ruledicaprio/solar-rfp-engine/rfp-hybrid-solar-td/review/ODGOVOR-RECENZENTU-2026-08-27.md

# Odgovor na komentare recenzenta — A. Čolpa, 27.08.2026

**Predmet:** komentari na `3.1 PRILOG II TD — predmjer Sjednica, Bileća` (7 komentara
u ćelijama) i na `proračuni_sjednica` (2 komentara, strana 4).
**Status:** svi komentari usvojeni i sprovedeni.
**Datum odgovora:** 14.09.2026.

Količine u odgovorima odnose se na važeći raspored temelja — **8 temeljnih traka**
(2 po nosaču). U verziji koju ste pregledali bilo ih je 6.

| # | Gdje | Komentar | Ishod |
|---|---|---|---|
| K1 | predmjer, 1.1 | tehničko rješenje uz ponudu | usvojeno |
| K2 | predmjer, 1.2 | izbaciti sile čupanja / podizanja / momente | usvojeno |
| K3 | predmjer, 1.3 | izbaciti pritisak vjetra i koeficijente; ostaviti standarde; proračun kao uslov za početak radova | usvojeno |
| K4 | predmjer, 2.1 | prekontrolisati iskop po traci | prekontrolisano |
| K5 | predmjer, 2.2 | nejasno zatrpavanje | stavka obrisana |
| K6 | predmjer, 2.2a | prekontrolisati nakon usaglašavanja 2.1 i 2.2 | prekontrolisano |
| K7 | predmjer, 2.3 | prekontrolisati količinu betona | prekontrolisano |
| P1 | proračun, B.3 | 110 kg po nosaču je premalo — brisati procjenu | usvojeno |
| P2 | proračun, B.6 | širi temelj u dnu se u stijeni teško izvodi | usvojeno |

---

## K1 — predmjer, stavka 1.1

> „U stavku 1.1 bih dodao da je ponuđač obavezan da uz ponudu dostavi tehničko rješenje
> konstrukcije za prihvat fotonaponskih panela sa obaveznim statičkim proračunom i
> specifikacijom materijala za predmetnu lokaciju."

**Sprovedeno.** Stavka 1.1 dobila je završni stav:

> „UZ PONUDU: Ponuđač je obavezan da uz ponudu dostavi tehničko rješenje konstrukcije
> za prihvat fotonaponskih panela za predmetnu lokaciju, sa obaveznim statičkim
> proračunom (Tačka 1.3) i specifikacijom materijala. Tehničko rješenje mora biti
> pregledano i odobreno prije početka izvođenja radova."

Isto je povučeno u Prilog I, Tačka 5 — dokaz br. 2 više nije samo „tehnički nacrti",
nego **tehničko rješenje konstrukcije** (nacrti + statički proračun + specifikacija
materijala), sa oznakom **PONUDA**.

## K2 — predmjer, stavka 1.2

> „Stavku 1.2 je potrebno pojednostaviti. Puno je zadano uslova koji navode na postojanje
> Glavnog projekta, kojeg nemamo. Mi tenderom tražimo izradu tehničkog rješenja, koje će
> definisati uslove ankerisanja konstrukcije. Treba izbjeći navođenje vrijednosti sila
> čupanja i podizanja, te momenata prevrtanja. […] ponuđači će nuditi različite koncepte
> konstrukcije […] iskazane vrijednosti sila i momenata prevrtanja […] uopšte ne moraju
> biti takve."

**Sprovedeno.** Iz stavke 1.2 uklonjene su sve tri zadane vrijednosti:
karakteristična sila čupanja **≥30 kN po ankeru**, projektna sila podizanja
**≥13,3 kN po nosaču** i sila po traci **≥16,1 kN**. Stav sada glasi:

> „nosivost i dubina ugradnje: prema ETA za konkretnu podlogu i prema statičkom
> proračunu iz Tačke 1.3; projektne sile ankerisanja proizlaze iz koncepta konstrukcije
> koji Ponuđač nudi i iskazuju se u tehničkom rješenju"

Isti zahvat je napravljen u **Prilogu I, Tačka 3.4 (Sidrenje)**, da specifikacija i
predmjer ne govore različito.

Zadržano je ispitivanje čupanjem na ≥10 % ugrađenih ankera do 1,5 × projektne sile —
ono se veže na silu iz ponuđačevog proračuna, ne na zadanu vrijednost.

## K3 — predmjer, stavka 1.3

> „Predlažem da se izbace vrijednosti pritiska vjetra i koeficijenata sigurnosti date
> stavkom 1.3. Ostaviti i naglasiti standarde na osnovu kojih će se raditi statički
> proračun nosive konstrukcije. Napomenu preformulisati na slijedeći način: Statički
> proračun se dostavlja u sklopu tehničkog rješenja i uslov je za počinjanje radova.
> (Statički proračun ne može biti uslov za primopredaju. Prije početka izvođenja radova
> tehničko rješenje mora biti pregledano i odobreno.)"

**Sprovedeno.** Iz stavke 1.3 izbačeni su `qp ≥ 1,20 kN/m² pri nagibu 45°` i
`γQ,dst = 1,5 / γG,stb = 0,9`. Ostali su samo standardi, uz **dopunu BAS EN 1993-1-1**
(dimenzionisanje čelične konstrukcije), koji je do sada nedostajao — bili su navedeni
samo standardi dejstava:

- BAS EN 1991-1-4 (vjetar, sa BiH nacionalnim aneksom, uključujući faktor orografije)
- BAS EN 1991-1-3 (snijeg) i radijalni led 20 mm gustine 300 kg/m³
- BAS EN 1990 (podizanje i prevrtanje)
- BAS EN 1993-1-1 (čelična konstrukcija), izvedba prema BAS EN 1090-2
- geotehnički uslovi lokacije i dubina smrzavanja

Napomena je preuzeta **doslovno po Vašem prijedlogu**. U Prilogu I, Tačka 5, uvedena je
nova oznaka **POČETAK RADOVA** i dokaz br. 1 (statički proračun) prebačen je sa
`REALIZACIJA` na `POČETAK RADOVA`.

**Jedna napomena za Vašu provjeru.** `qp ≥ 1,20 kN/m²` i `cf ≥ 1,5` zadržani su u
**Prilogu I, Tačka 3.2**, ali ne kao zahtjev prema konstrukciji, nego kao **podatak
lokaliteta** — preuzeti su iz ovjerene projektne dokumentacije lokacije i ne zavise od
koncepta koji ponuđač nudi. To je ujedno i razlog zbog kojeg se kataloški nosač ne može
prihvatiti (deklarisan na 0,52–0,87 kN/m²). Sile izvedene iz njih (podizanje,
horizontalna sila, moment prevrtanja, spreg po traci) sada su u 3.2 **izričito označene
kao orijentacione**, uz rečenicu „Projektne sile po nosaču se ne zadaju." Ako i te
orijentacione vrijednosti treba ukloniti, javite — brišu se u jednom potezu.

## K4 — predmjer, stavka 2.1 (iskop)

> „Prekontrolisati količinu iskopa po jednoj temeljnoj traci"

**Prekontrolisano, količina se ne mijenja: 9,88 m³.** Rov je sada jednoznačno opisan u
samoj stavci — širina **500 mm**, dubina **950 mm** (900 mm trake + 50 mm podložnog
betona), dužina **2600 mm**:

```
0,500 × 0,950 × 2,600 = 1,235 m³ po traci
1,235 × 8 traka       = 9,88 m³
```

Rov se siječe jednom širinom po cijeloj dubini (vidi P2), pa je osnovica rova jednaka
širini trake.

## K5 — predmjer, stavka 2.2 (zatrpavanje)

> „Nije jasno o kakvom se zatrpavanju radi, ako je količina betona približno ili skoro
> identična iskopu. Prekontrolisati stavku."

**Stavka je obrisana.** Nakon što je presjek trake postao jedinstven (P2), rov je
ispunjen u cijelosti i zatrpavanja nema:

```
beton            1,170 m³
podložni beton   0,065 m³
                 ───────
ukupno           1,235 m³  =  zapremina rova iz K4
```

Sekcija 2 je zbog toga prenumerisana **2.1 … 2.6**; jedina unakrsna referenca u
predmjeru (stavka 1.2 → „Tačka 2.3") povučena je na **Tačku 2.4**.

## K6 — predmjer, stavka 2.2a (odvoz)

> „Prekontrolisati stavku nakon usaglašavanja stavki 2.1 i 2.2"

**Prekontrolisano: 8,94 → 9,88 m³** (nova oznaka stavke: **2.2**). Pošto zatrpavanja
nema, odvozi se **sav** iskopani materijal, pa je količina jednaka iskopu iz K4.

## K7 — predmjer, stavka 2.3 (beton)

> „Prekontrolisati količinu betona. Po nacrtu datom kroz TD, količina betona je puno
> veća."

**Prekontrolisano — bili ste u pravu.** Predmjer koji ste pregledali nosio je
0,41 m³ po traci (2,44 m³ ukupno), dok je na crtežu traka puna dubine. Količina je
usaglašena sa crtežom i sada iznosi **9,36 m³** (nova oznaka stavke: **2.4**):

```
0,500 × 0,900 × 2,600 = 1,170 m³ po traci
1,170 × 8 traka       = 9,36 m³
```

Stavka sada nosi i samu izvedbu količine, pa se provjera može ponoviti iz teksta. Uz
istu izmjenu, količina obrade vidljivih površina (sada stavka **2.5**) povučena je sa
zatečenih 12 m² na izvedenih **10,4 m²** (0,50 × 2,60 × 8).

## P1 — proračun, strana 4, tačka B.3 (masa nosača)

> „110 kg po jednom nosaču je jako malo. Predlažem brisanje procjenjene količine.
> Ostaviti samo potvrđuje izvođač proračunom."

**Sprovedeno.** Brojka je obrisana iz svih tabela. U dokazu na podizanje **vlastita
težina konstrukcije se sada zanemaruje**: ona je povoljno dejstvo, pa je njeno
izostavljanje na strani sigurnosti, a stvarna masa dokaz može samo poboljšati. U
stabilizujućem dejstvu `G` ostaju samo moduli.

Posljedica je jedna izmijenjena vrijednost:

| | ranije | sada |
|---|---|---|
| `G` (stabilizujuće) | 1,9 kN (moduli + procijenjeni ram) | **0,94 kN** (samo moduli) |
| **ULS uzgon po nosaču** | 13,3 kN | **14,1 kN** |

Moment prevrtanja (25,7 kNm), spreg po traci (16,1 kN) i potrebna zapremina trake
(0,74 m³) ne zavise od mase rama i nepromijenjeni su.

## P2 — proračun, strana 4, tačka B.6 (dimenzija trake)

> „U stijeni je širi temelj u dnu jako teško izvesti. Predlažem da se dimenzija dole
> izbaci."

**Sprovedeno.** Traka je sada **jedinstvenog presjeka po cijeloj dubini**, bez
proširenja u dnu — rov se u stijeni siječe jednom širinom, a potkopavanje se ne traži.

Od dvije zatečene kote (400 gore / 500 dolje) usvojena je **veća, 500 mm**, iz dva
razloga: rov se ionako siječe na 500 mm pa se količina iskopa ne mijenja, a ankerima
ostaje 250 mm ivične udaljenosti umjesto 200 mm. Dokaz na podizanje se pritom
popravlja:

```
vlastita težina trake   1,170 × 24        =  28,1 kN
faktorisano             0,9 × 28,1        =  25,3 kN   ≥ 16,1 kN (spreg po traci)
```

**Ako ipak preferirate 400 mm** — tj. doslovno zadržavanje gornje kote — količine
slijede bez daljeg preračunavanja, a dokaz na podizanje i dalje prolazi:

| | 500 mm (usvojeno) | 400 mm (varijanta) |
|---|---|---|
| Beton po traci | 1,170 m³ | 0,936 m³ |
| Beton ukupno (8 traka) | 9,36 m³ | 7,49 m³ |
| Iskop ukupno | 9,88 m³ | 7,90 m³ |
| Odvoz ukupno | 9,88 m³ | 7,90 m³ |
| Obrada gornjih površina | 10,4 m² | 8,3 m² |
| Faktorisana težina trake | 25,3 kN | 20,2 kN |
| Prema spregu 16,1 kN | 1,57 × | 1,26 × |

Recite koju varijantu zadržavamo; u predmjer ide u jednom potezu.

---

## Gdje se izmjene vide

| Dokument | Šta je izmijenjeno |
|---|---|
| `PRILOG II — LOT 1` (obje lokacije) | stavke 1.1, 1.2, 1.3; sekcija 2 prenumerisana 2.1–2.6, obrisano zatrpavanje, količine 2.2/2.4/2.5 |
| `PRILOG I`, Tačka 3.2 | qp i cf kao podatak lokaliteta; izvedene sile označene kao orijentacione |
| `PRILOG I`, Tačka 3.4 | uklonjene zadane sile ankerisanja |
| `PRILOG I`, Tačka 3.5 | traka 500 × 2600 mm jedinstvene širine, 1,170 / 9,36 m³ |
| `PRILOG I`, Tačka 5 | nova oznaka POČETAK RADOVA; dokazi 1 i 2 |
| `proračuni`, B.3 / B.5 / B.6 | masa rama obrisana, uzgon 14,1 kN, traka jedinstvenog presjeka, izvedene količine |
| crteži `S-02`, `H-02`, `H-03` | kota trake ispisana kao jedna širina (500 × 2600 mm) |
