ruledicaprio/solar-rfp-engine/bht-sjednica-final-review/review/pvsim/fig/f5_gubici_t45.png

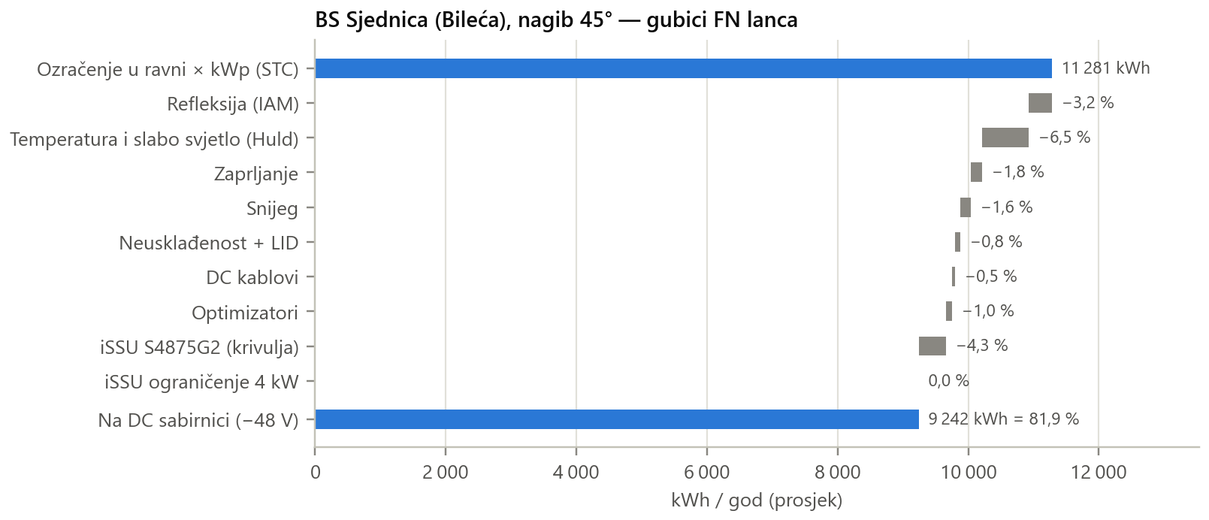
bht-sjednica-final-review/review/pvsim/fig/f5_gubici_t45.png
