ruledicaprio/solar-rfp-engine/hamzici-hybrid-solar/review/pvsim/fig/f5_gubici_t45.png

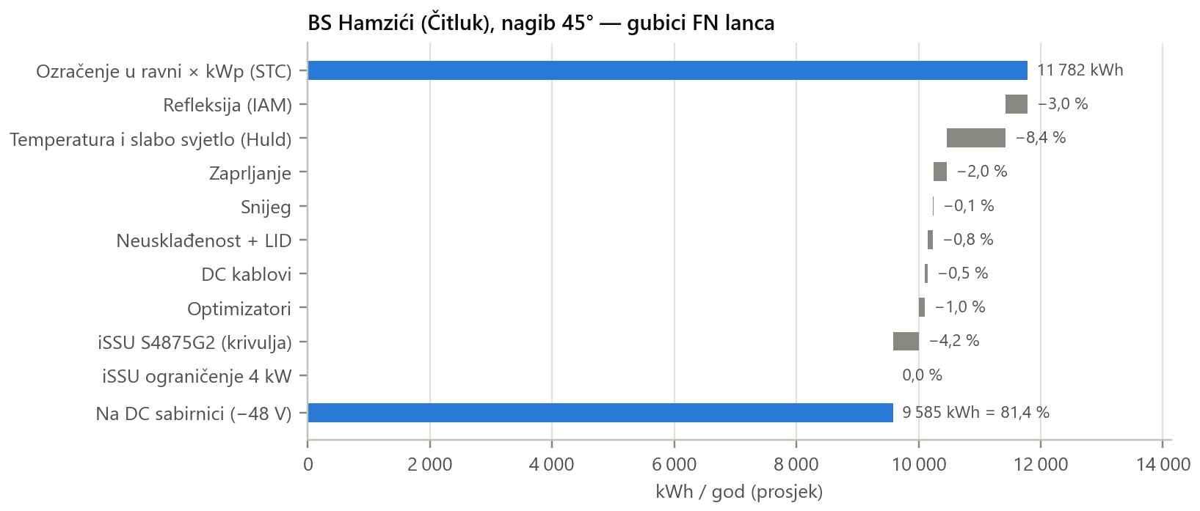
hamzici-hybrid-solar/review/pvsim/fig/f5_gubici_t45.png
