ruledicaprio/solar-rfp-engine/hamzici-hybrid-solar/review/pvsim/fig/f6_nagibi.png

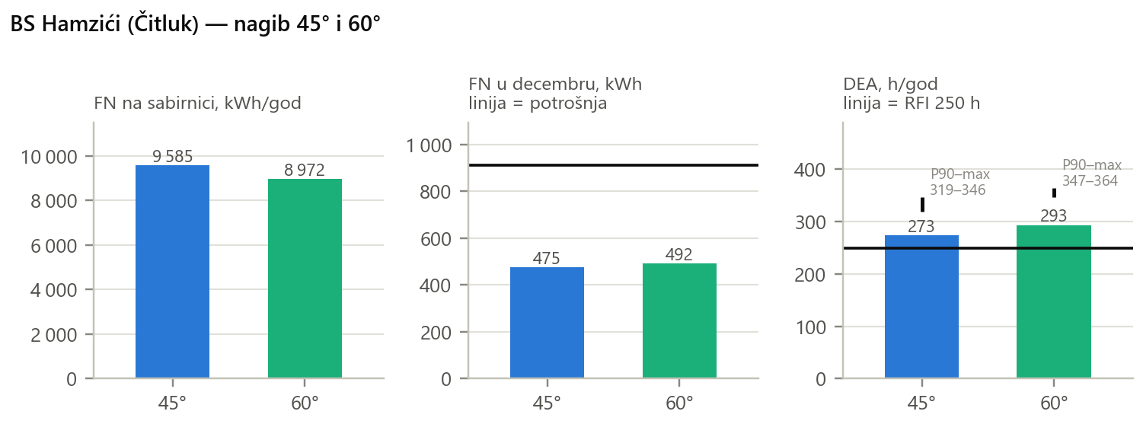
hamzici-hybrid-solar/review/pvsim/fig/f6_nagibi.png
