ruledicaprio/solar-rfp-engine/bht-sjednica-final-review/TD-OUTPUT/grafika/S-03.dxf

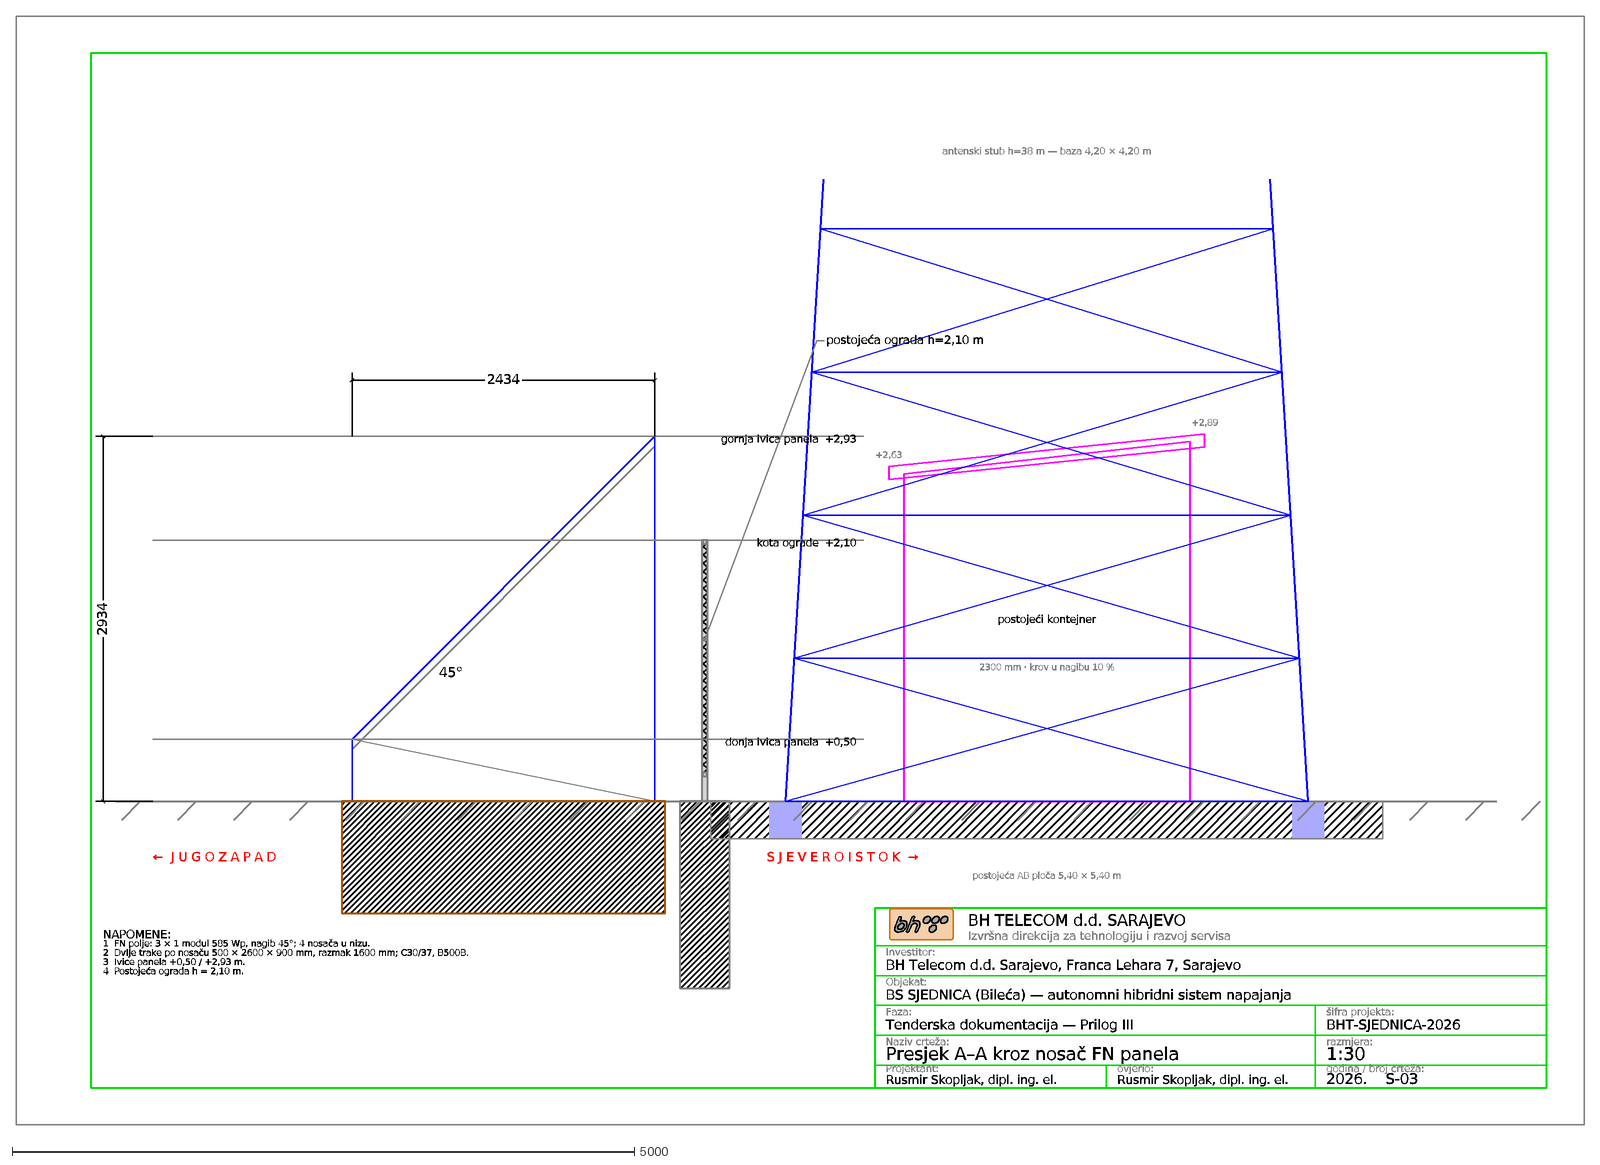
[picture p16: CAD file, 2026-10-05]
bht-sjednica-final-review/TD-OUTPUT/grafika/S-03.dxf
BH TELECOM d.d. SARAJEVO
Izvršna direkcija za tehnologiju i razvoj servisa
Investitor:
BH Telecom d.d. Sarajevo, Franca Lehara 7, Sarajevo
Objekat:
BS SJEDNICA (Bileća) — autonomni hibridni sistem napajanja
Faza:
Tenderska dokumentacija — Prilog III
šifra projekta:
BHT-SJEDNICA-2026
Naziv crteža:
Presjek A–A kroz nosač FN panela
razmjera:
1:30
Projektant:
Rusmir Skopljak, dipl. ing. el.
ovjerio:
godina / broj crteža:
2026. S-03
postojeći kontejner
2300 mm · krov u nagibu 10 %
+2,63
+2,89
postojeća AB ploča 5,40 × 5,40 m
antenski stub h=38 m — baza 4,20 × 4,20 m
donja ivica panela +0,50
kota ograde +2,10
gornja ivica panela +2,93
2434
2934
45°
S J E V E R O I S T O K →
← J U G O Z A P A D
postojeća ograda h=2,10 m
NAPOMENE:
1 FN polje: 3 × 1 modul 585 Wp, nagib 45°; 4 nosača u nizu.
2 Dvije trake po nosaču 500 × 2600 × 900 mm, razmak 1600 mm; C30/37, B500B.
3 Ivice panela +0,50 / +2,93 m.
4 Postojeća ograda h = 2,10 m.
