ruledicaprio/solar-rfp-engine/hamzici-hybrid-solar/TD-OUTPUT/grafika/H-06.dxf

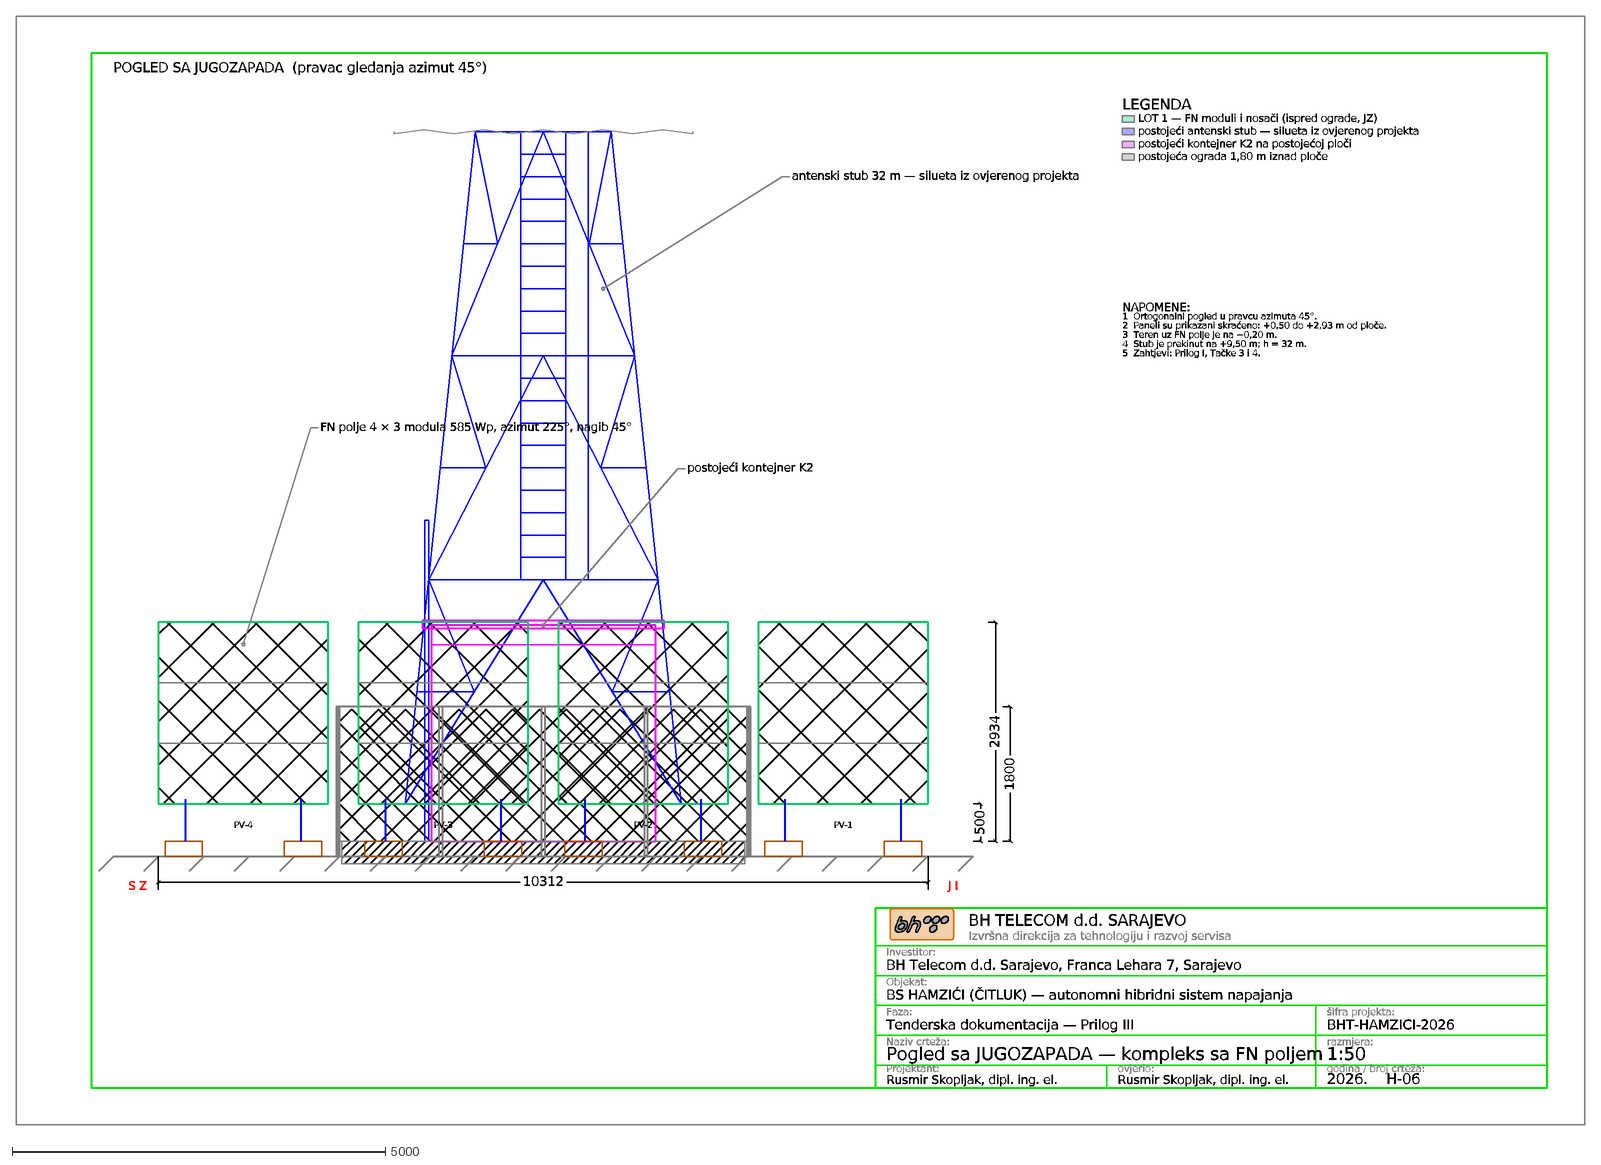
[picture p17: CAD file, 2026-10-05]
hamzici-hybrid-solar/TD-OUTPUT/grafika/H-06.dxf
BH TELECOM d.d. SARAJEVO
Izvršna direkcija za tehnologiju i razvoj servisa
Investitor:
BH Telecom d.d. Sarajevo, Franca Lehara 7, Sarajevo
Objekat:
BS HAMZIĆI (ČITLUK) — autonomni hibridni sistem napajanja
Faza:
Tenderska dokumentacija — Prilog III
šifra projekta:
BHT-HAMZICI-2026
Naziv crteža:
Pogled sa JUGOZAPADA — kompleks sa FN poljem
razmjera:
1:50
Projektant:
Rusmir Skopljak, dipl. ing. el.
ovjerio:
godina / broj crteža:
2026. H-06
PV-1
PV-2
PV-3
PV-4
10312
500
2934
1800
S Z
J I
POGLED SA JUGOZAPADA (pravac gledanja azimut 45°)
postojeći kontejner K2
antenski stub 32 m — silueta iz ovjerenog projekta
FN polje 4 × 3 modula 585 Wp, azimut 225°, nagib 45°
LEGENDA
LOT 1 — FN moduli i nosači (ispred ograde, JZ)
postojeći antenski stub — silueta iz ovjerenog projekta
postojeći kontejner K2 na postojećoj ploči
postojeća ograda 1,80 m iznad ploče
NAPOMENE:
1 Ortogonalni pogled u pravcu azimuta 45°.
2 Paneli su prikazani skraćeno: +0,50 do +2,93 m od ploče.
3 Teren uz FN polje je na −0,20 m.
4 Stub je prekinut na +9,50 m; h = 32 m.
5 Zahtjevi: Prilog I, Tačke 3 i 4.
