ruledicaprio/solar-rfp-engine/rfp-hybrid-solar-td/TD-OUTPUT/grafika/hamzici/H-02.dxf

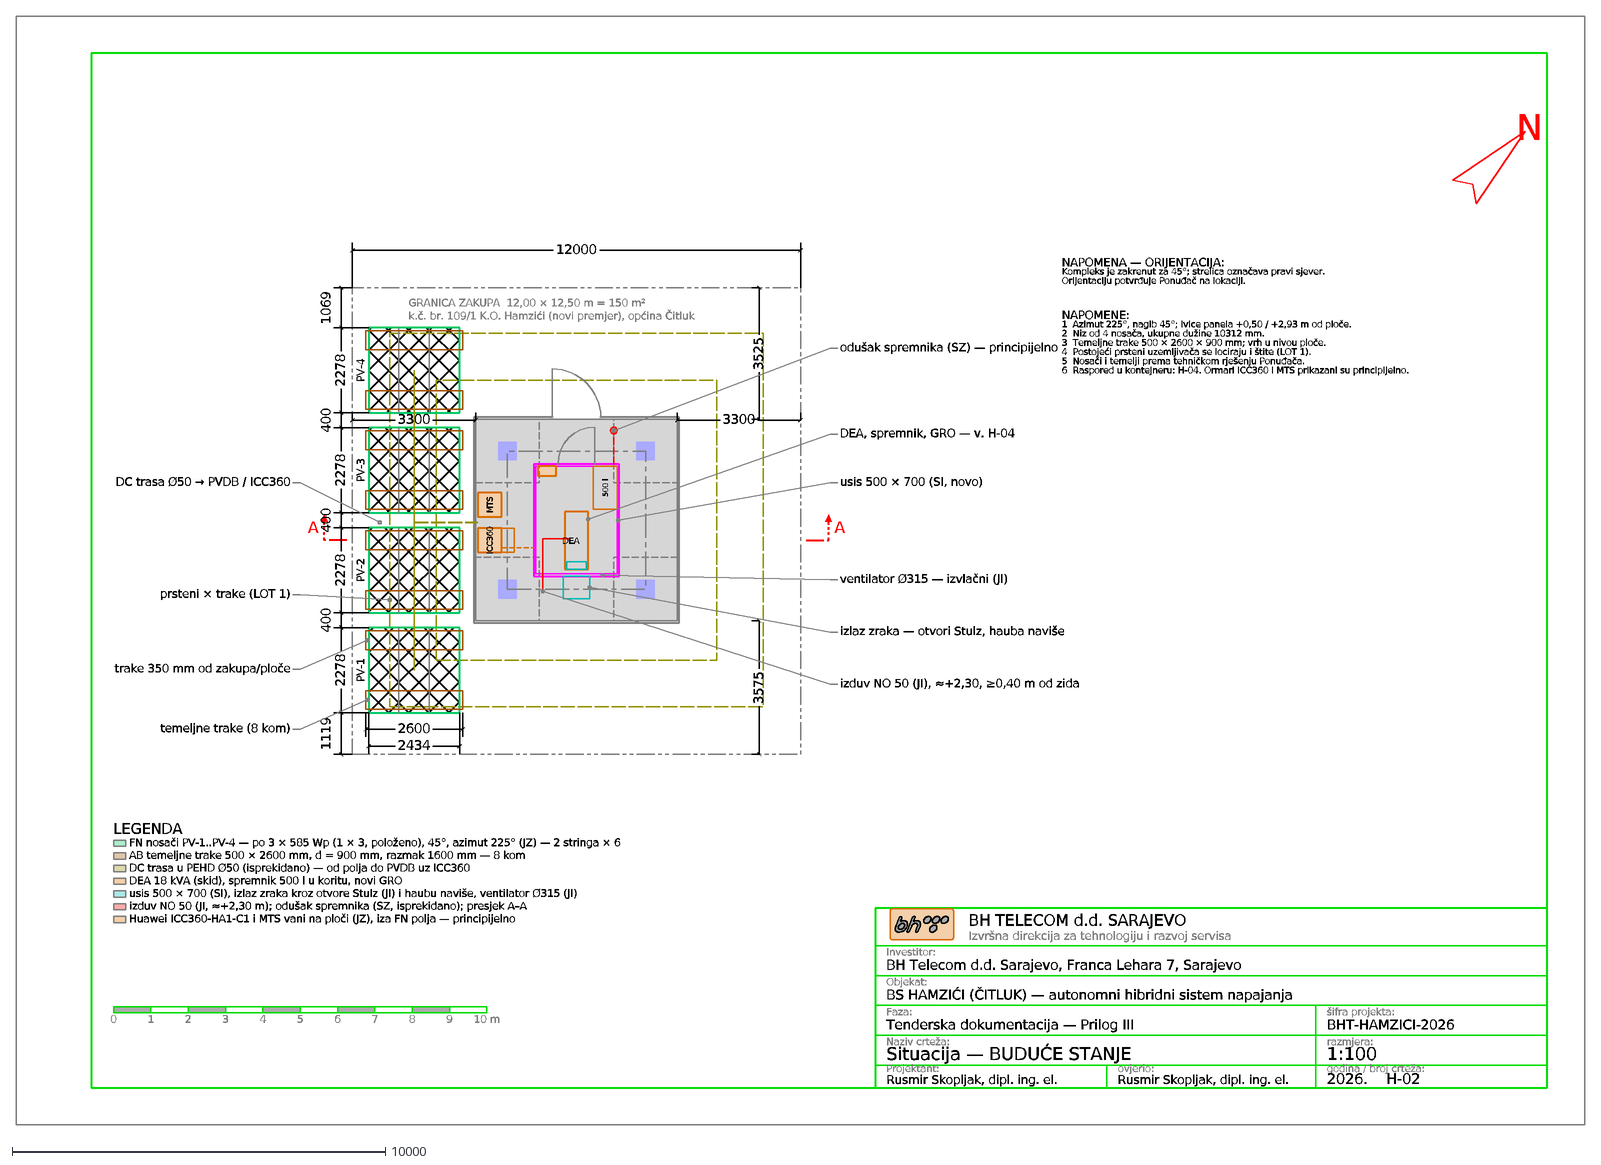
[picture p18: CAD file, 2026-10-05]
rfp-hybrid-solar-td/TD-OUTPUT/grafika/hamzici/H-02.dxf
BH TELECOM d.d. SARAJEVO
Izvršna direkcija za tehnologiju i razvoj servisa
Investitor:
BH Telecom d.d. Sarajevo, Franca Lehara 7, Sarajevo
Objekat:
BS HAMZIĆI (ČITLUK) — autonomni hibridni sistem napajanja
Faza:
Tenderska dokumentacija — Prilog III
šifra projekta:
BHT-HAMZICI-2026
Naziv crteža:
Situacija — BUDUĆE STANJE
razmjera:
1:100
Projektant:
Rusmir Skopljak, dipl. ing. el.
ovjerio:
godina / broj crteža:
2026. H-02
GRANICA ZAKUPA 12,00 × 12,50 m = 150 m²
k.č. br. 109/1 K.O. Hamzići (novi premjer), općina Čitluk
DEA
500 l
12000
3525
3575
3300
PV-1
PV-2
PV-3
PV-4
A
ICC360
MTS
1119
2278
400
1069
2600
2434
temeljne trake (8 kom)
trake 350 mm od zakupa/ploče
prsteni × trake (LOT 1)
DC trasa Ø50 → PVDB / ICC360
odušak spremnika (SZ) — principijelno
DEA, spremnik, GRO — v. H-04
usis 500 × 700 (SI, novo)
ventilator Ø315 — izvlačni (JI)
izlaz zraka — otvori Stulz, hauba naviše
izduv NO 50 (JI), ≈+2,30, ≥0,40 m od zida
N
0
1
2
3
4
5
6
7
8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
