ruledicaprio/solar-rfp-engine/bht-sjednica-final-review/TD-OUTPUT/grafika/M-01.dxf

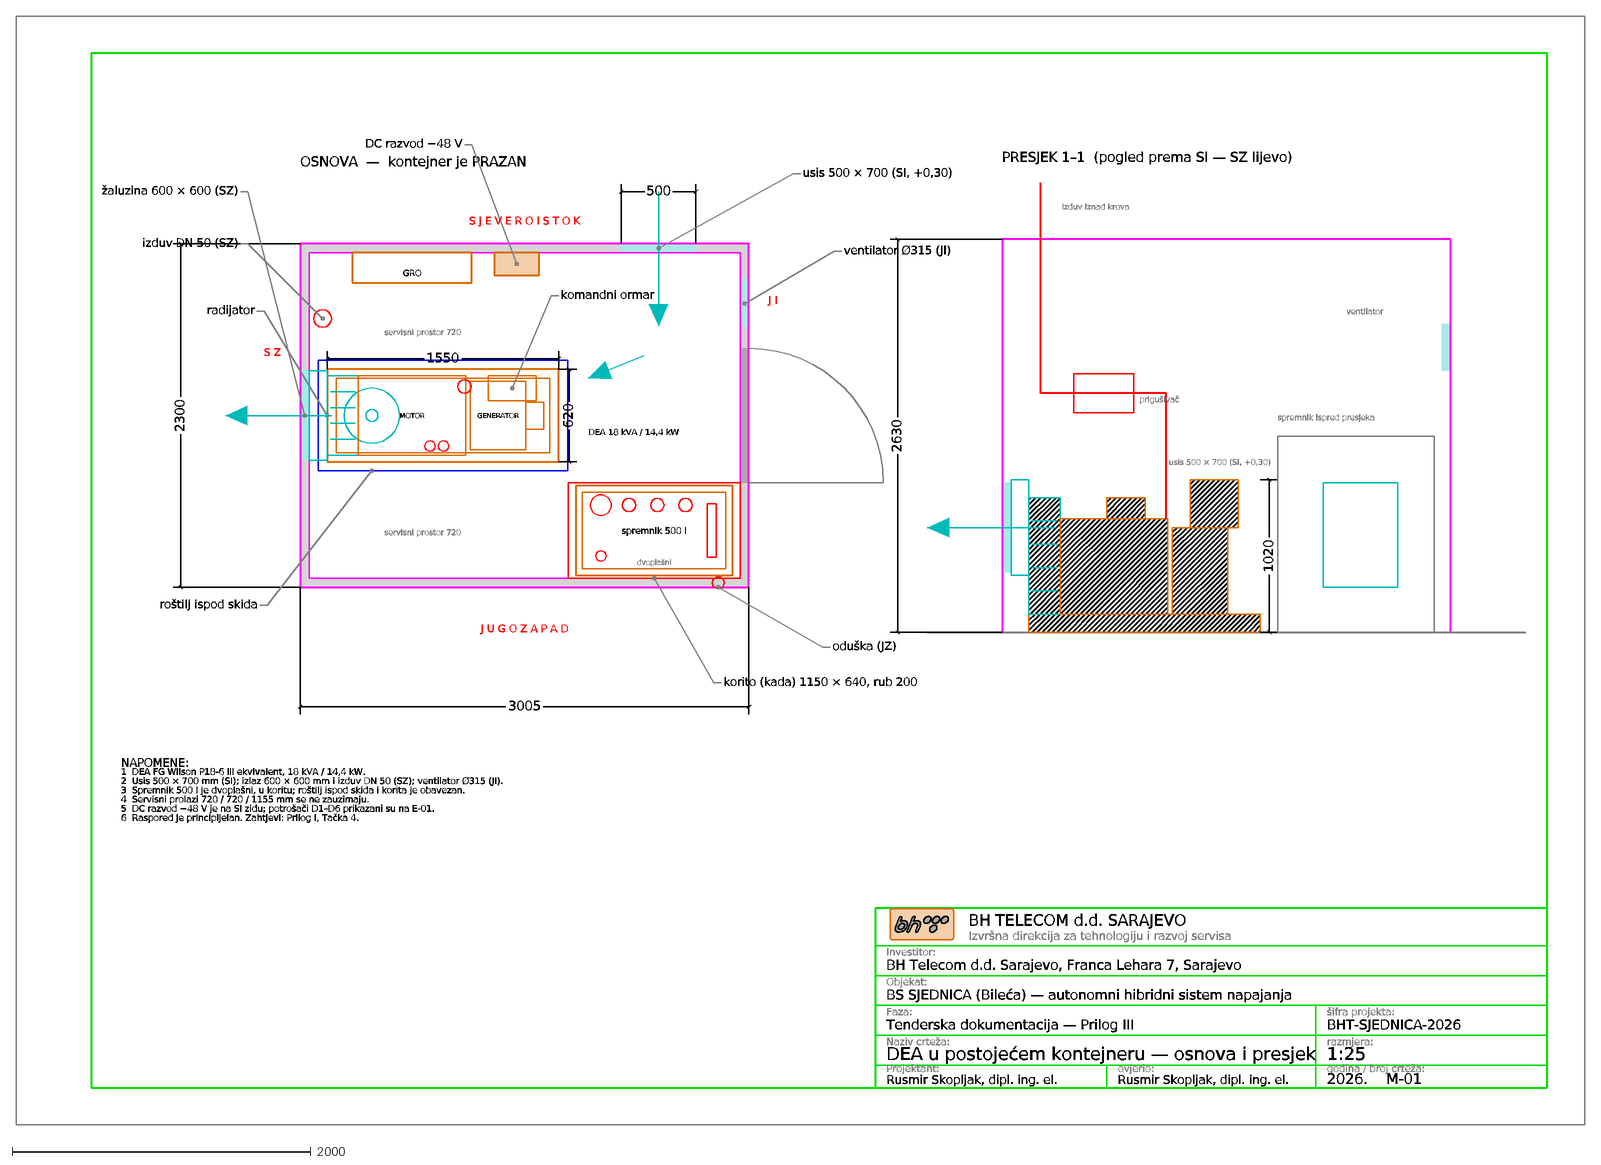
[picture p19: CAD file, 2026-10-05]
bht-sjednica-final-review/TD-OUTPUT/grafika/M-01.dxf
BH TELECOM d.d. SARAJEVO
Izvršna direkcija za tehnologiju i razvoj servisa
Investitor:
BH Telecom d.d. Sarajevo, Franca Lehara 7, Sarajevo
Objekat:
BS SJEDNICA (Bileća) — autonomni hibridni sistem napajanja
Faza:
Tenderska dokumentacija — Prilog III
šifra projekta:
BHT-SJEDNICA-2026
Naziv crteža:
DEA u postojećem kontejneru — osnova i presjek
razmjera:
1:25
Projektant:
Rusmir Skopljak, dipl. ing. el.
ovjerio:
godina / broj crteža:
2026. M-01
OSNOVA — kontejner je PRAZAN
MOTOR
GENERATOR
1550
620
radijator
komandni ormar
DEA 18 kVA / 14,4 kW
GRO
DC razvod −48 V
spremnik 500 l
dvoplašni
servisni prostor 720
3005
2300
500
usis 500 × 700 (SI, +0,30)
žaluzina 600 × 600 (SZ)
izduv DN 50 (SZ)
korito (kada) 1150 × 640, rub 200
oduška (JZ)
ventilator Ø315 (JI)
roštilj ispod skida
S J E V E R O I S T O K
J U G O Z A P A D
S Z
J I
PRESJEK 1–1 (pogled prema SI — SZ lijevo)
1020
prigušivač
izduv iznad krova
spremnik ispred presjeka
ventilator
2630
NAPOMENE:
1 DEA FG Wilson P18-6 ili ekvivalent, 18 kVA / 14,4 kW.
2 Usis 500 × 700 mm (SI); izlaz 600 × 600 mm i izduv DN 50 (SZ); ventilator Ø315 (JI).
3 Spremnik 500 l je dvoplašni, u koritu; roštilj ispod skida i korita je obavezan.
4 Servisni prolazi 720 / 720 / 1155 mm se ne zauzimaju.
5 DC razvod −48 V je na SI zidu; potrošači D1–D6 prikazani su na E-01.
6 Raspored je principijelan. Zahtjevi: Prilog I, Tačka 4.
