ruledicaprio/solar-rfp-engine/hamzici-hybrid-solar/TD-OUTPUT/grafika/H-03.dxf

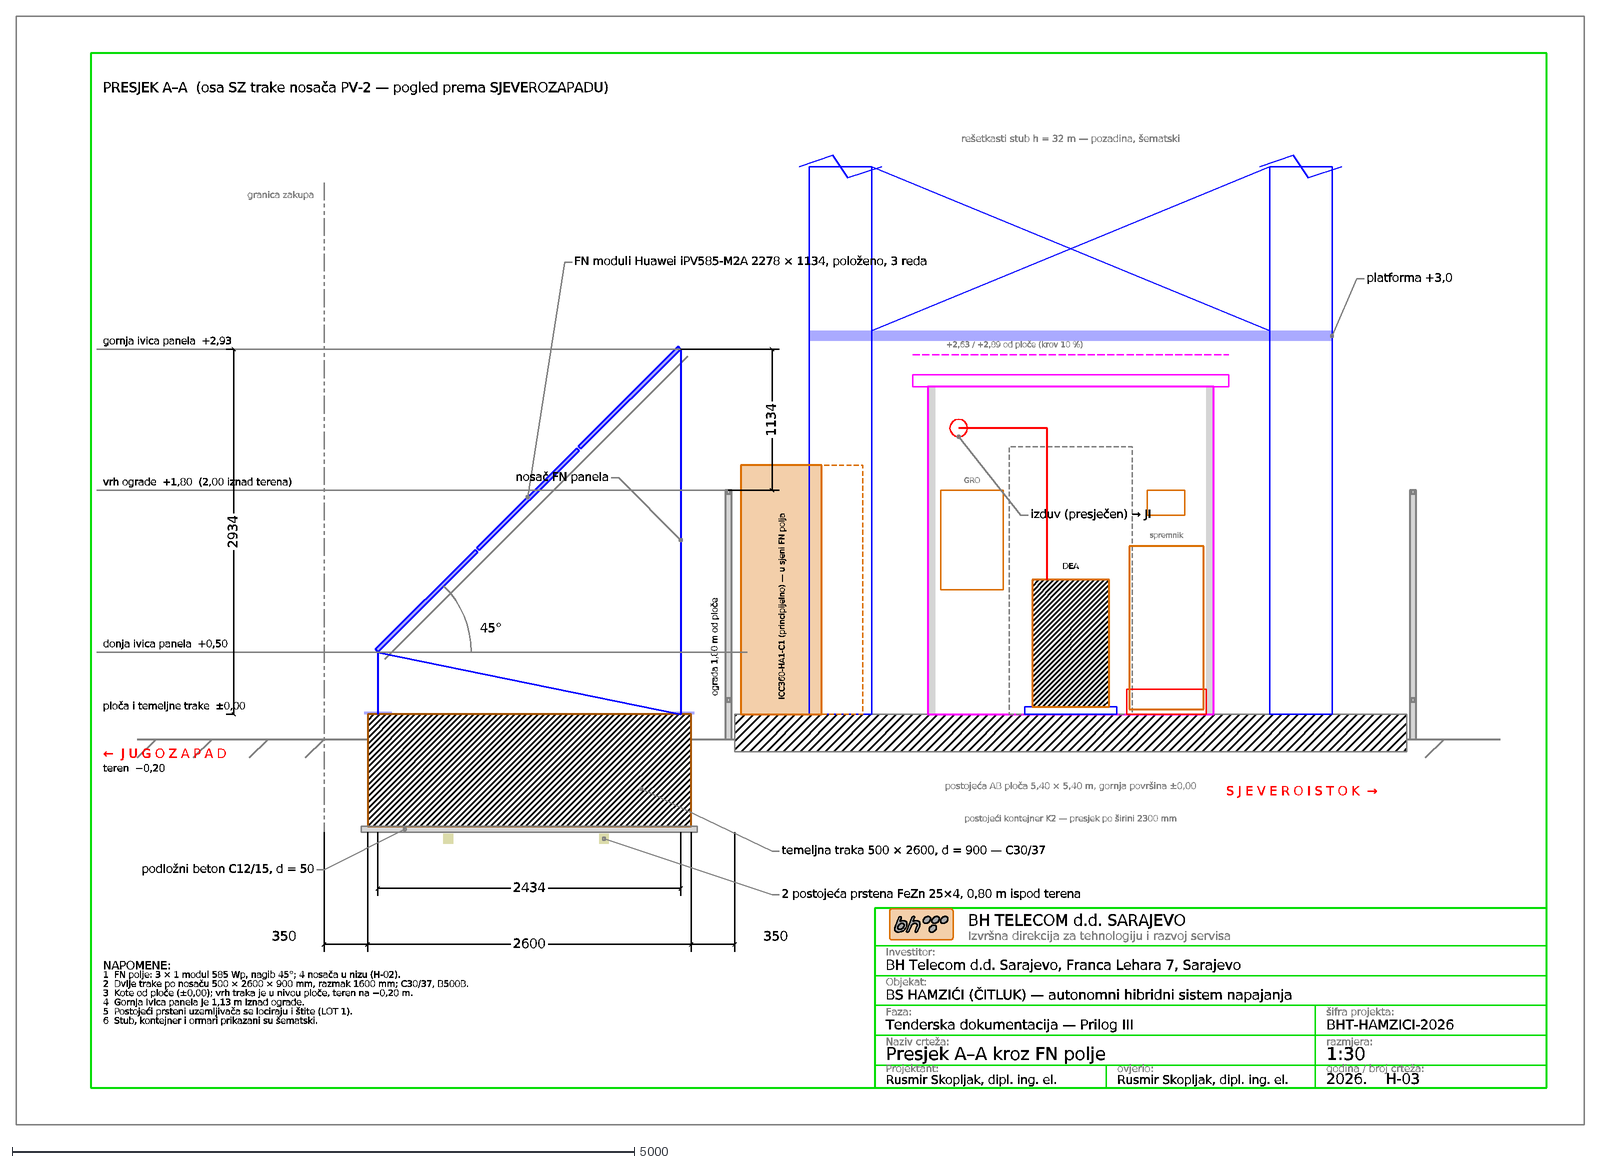
[picture p20: CAD file, 2026-10-05]
hamzici-hybrid-solar/TD-OUTPUT/grafika/H-03.dxf
BH TELECOM d.d. SARAJEVO
Izvršna direkcija za tehnologiju i razvoj servisa
Investitor:
BH Telecom d.d. Sarajevo, Franca Lehara 7, Sarajevo
Objekat:
BS HAMZIĆI (ČITLUK) — autonomni hibridni sistem napajanja
Faza:
Tenderska dokumentacija — Prilog III
šifra projekta:
BHT-HAMZICI-2026
Naziv crteža:
Presjek A–A kroz FN polje
razmjera:
1:30
Projektant:
Rusmir Skopljak, dipl. ing. el.
ovjerio:
godina / broj crteža:
2026. H-03
granica zakupa
45°
ograda 1,80 m od ploče
postojeća AB ploča 5,40 × 5,40 m, gornja površina ±0,00
rešetkasti stub h = 32 m — pozadina, šematski
platforma +3,0
ICC360-HA1-C1 (principijelno) — u sjeni FN polja
+2,63 / +2,89 od ploče (krov 10 %)
GRO
spremnik
DEA
postojeći kontejner K2 — presjek po širini 2300 mm
donja ivica panela +0,50
vrh ograde +1,80 (2,00 iznad terena)
gornja ivica panela +2,93
ploča i temeljne trake ±0,00
teren −0,20
2934
1134
2434
350
2600
FN moduli Huawei iPV585-M2A 2278 × 1134, položeno, 3 reda
nosač FN panela
temeljna traka 500 × 2600, d = 900 — C30/37
2 postojeća prstena FeZn 25×4, 0,80 m ispod terena
podložni beton C12/15, d = 50
izduv (presječen) → JI
PRESJEK A–A (osa SZ trake nosača PV-2 — pogled prema SJEVEROZAPADU)
← J U G O Z A P A D
S J E V E R O I S T O K →
NAPOMENE:
1 FN polje: 3 × 1 modul 585 Wp, nagib 45°; 4 nosača u nizu (H-02).
2 Dvije trake po nosaču 500 × 2600 × 900 mm, razmak 1600 mm; C30/37, B500B.
3 Kote od ploče (±0,00); vrh traka je u nivou ploče, teren na −0,20 m.
4 Gornja ivica panela je 1,13 m iznad ograde.
5 Postojeći prsteni uzemljivača se lociraju i štite (LOT 1).
6 Stub, kontejner i ormari prikazani su šematski.
