ruledicaprio/solar-rfp-engine/bht-sjednica-final-review/TD-OUTPUT/grafika/S-04.dxf

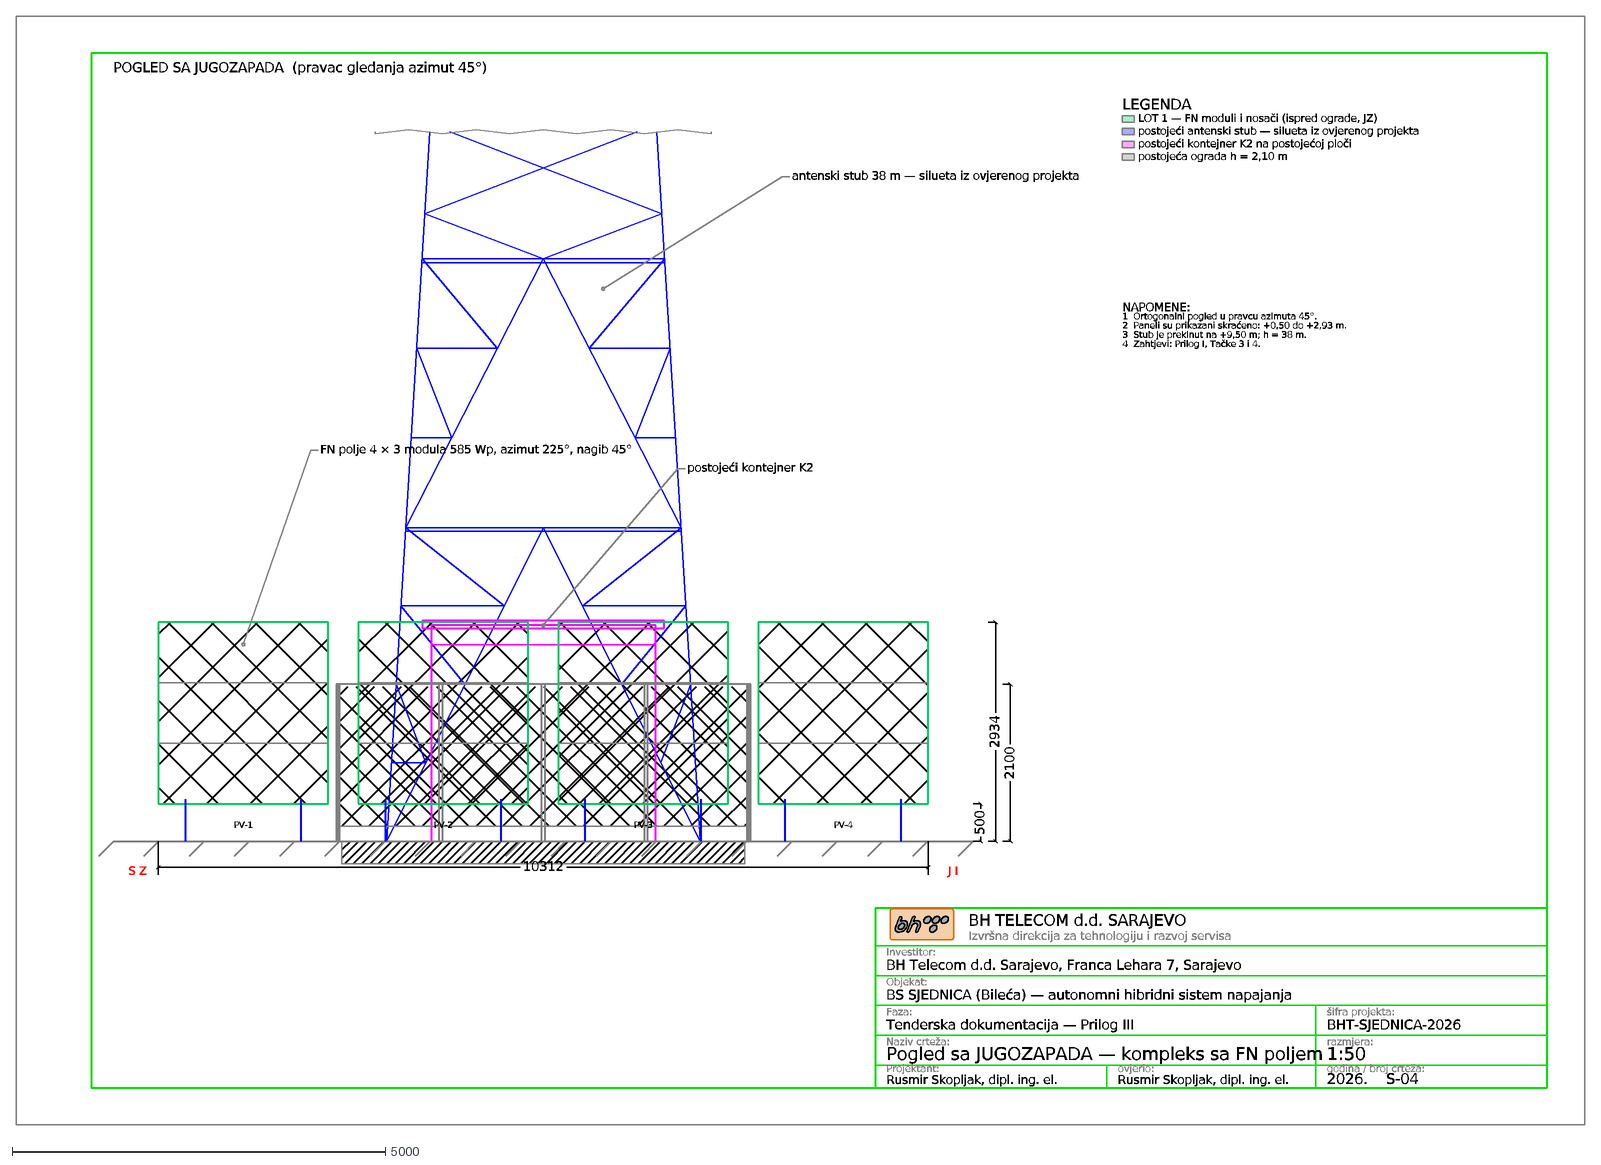
[picture p21: CAD file, 2026-10-05]
bht-sjednica-final-review/TD-OUTPUT/grafika/S-04.dxf
BH TELECOM d.d. SARAJEVO
Izvršna direkcija za tehnologiju i razvoj servisa
Investitor:
BH Telecom d.d. Sarajevo, Franca Lehara 7, Sarajevo
Objekat:
BS SJEDNICA (Bileća) — autonomni hibridni sistem napajanja
Faza:
Tenderska dokumentacija — Prilog III
šifra projekta:
BHT-SJEDNICA-2026
Naziv crteža:
Pogled sa JUGOZAPADA — kompleks sa FN poljem
razmjera:
1:50
Projektant:
Rusmir Skopljak, dipl. ing. el.
ovjerio:
godina / broj crteža:
2026. S-04
PV-1
PV-2
PV-3
PV-4
10312
500
2934
2100
S Z
J I
POGLED SA JUGOZAPADA (pravac gledanja azimut 45°)
postojeći kontejner K2
antenski stub 38 m — silueta iz ovjerenog projekta
FN polje 4 × 3 modula 585 Wp, azimut 225°, nagib 45°
LEGENDA
LOT 1 — FN moduli i nosači (ispred ograde, JZ)
postojeći antenski stub — silueta iz ovjerenog projekta
postojeći kontejner K2 na postojećoj ploči
postojeća ograda h = 2,10 m
NAPOMENE:
1 Ortogonalni pogled u pravcu azimuta 45°.
2 Paneli su prikazani skraćeno: +0,50 do +2,93 m.
3 Stub je prekinut na +9,50 m; h = 38 m.
4 Zahtjevi: Prilog I, Tačke 3 i 4.
