ruledicaprio/solar-rfp-engine/bht-sjednica-final-review/TD-OUTPUT/grafika/S-02.dxf

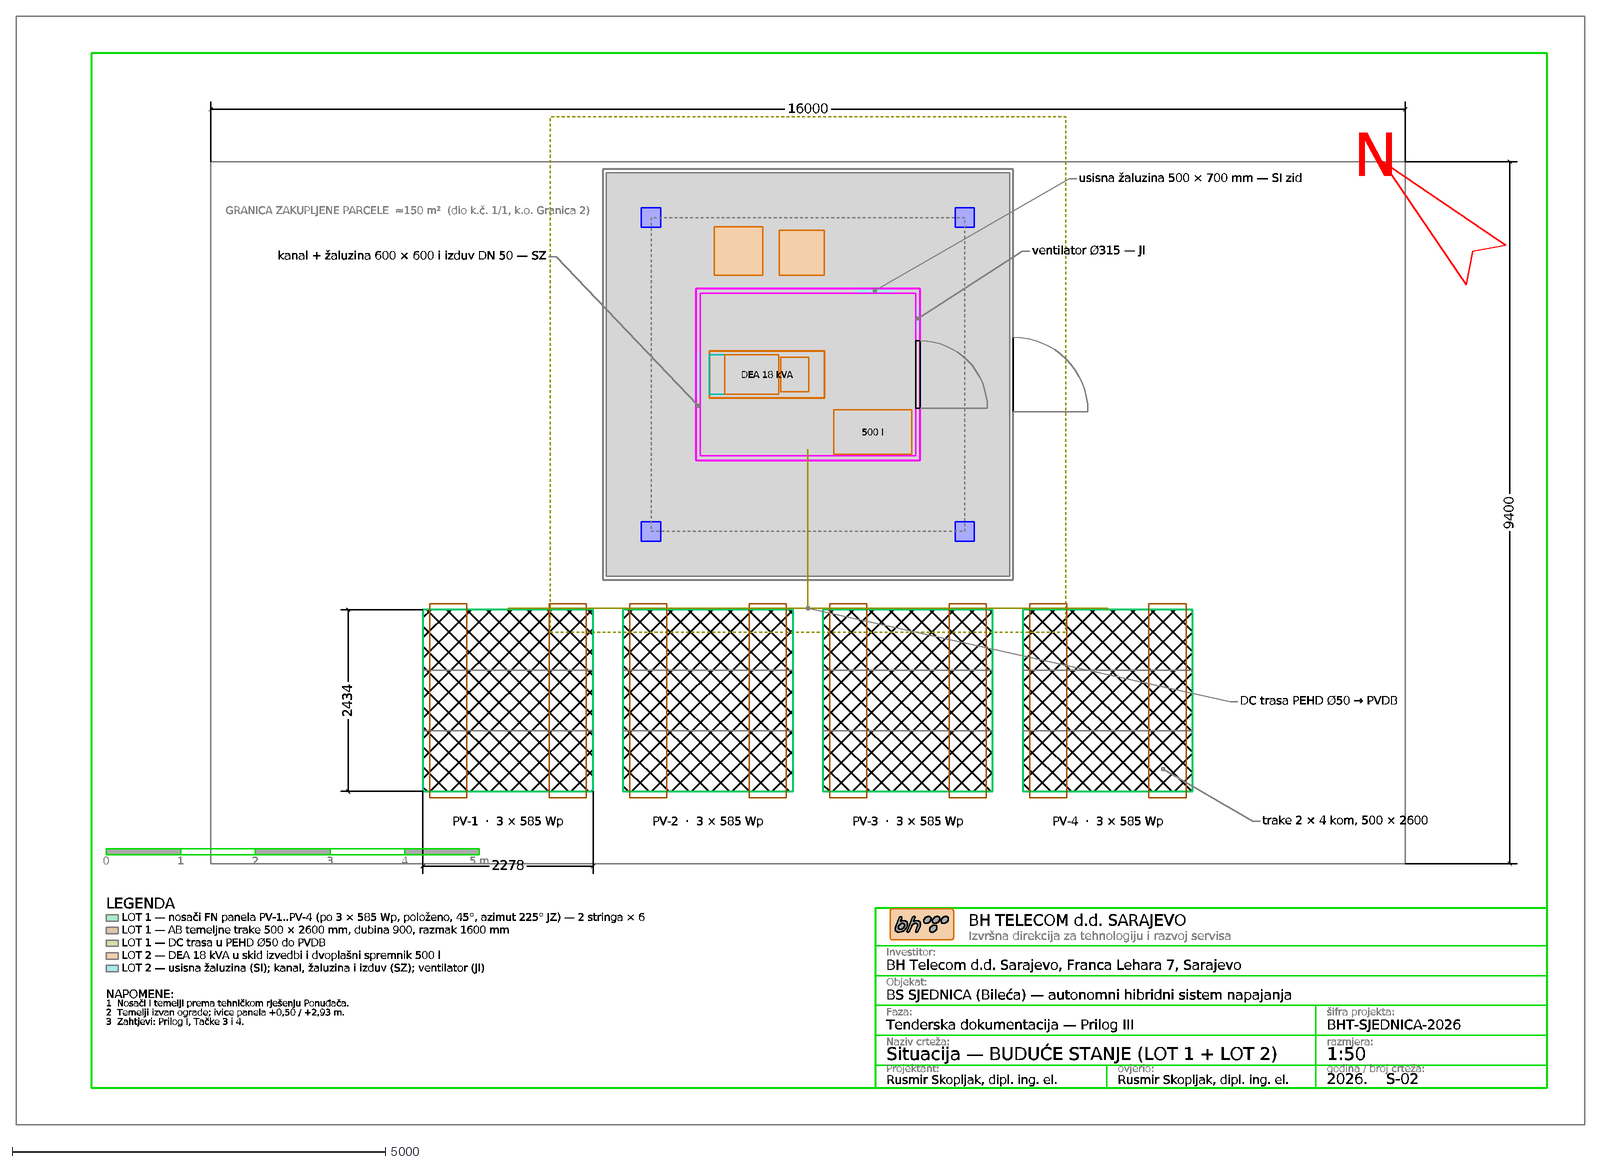
[picture p24: CAD file, 2026-10-05]
bht-sjednica-final-review/TD-OUTPUT/grafika/S-02.dxf
BH TELECOM d.d. SARAJEVO
Izvršna direkcija za tehnologiju i razvoj servisa
Investitor:
BH Telecom d.d. Sarajevo, Franca Lehara 7, Sarajevo
Objekat:
BS SJEDNICA (Bileća) — autonomni hibridni sistem napajanja
Faza:
Tenderska dokumentacija — Prilog III
šifra projekta:
BHT-SJEDNICA-2026
Naziv crteža:
Situacija — BUDUĆE STANJE (LOT 1 + LOT 2)
razmjera:
1:50
Projektant:
Rusmir Skopljak, dipl. ing. el.
ovjerio:
godina / broj crteža:
2026. S-02
GRANICA ZAKUPLJENE PARCELE ≈150 m² (dio k.č. 1/1, k.o. Granica 2)
PV-1 · 3 × 585 Wp
PV-2 · 3 × 585 Wp
PV-3 · 3 × 585 Wp
PV-4 · 3 × 585 Wp
DEA 18 kVA
500 l
2278
2434
16000
9400
usisna žaluzina 500 × 700 mm — SI zid
kanal + žaluzina 600 × 600 i izduv DN 50 — SZ
ventilator Ø315 — JI
DC trasa PEHD Ø50 → PVDB
trake 2 × 4 kom, 500 × 2600
N
0
1
2
3
4
5 m
LEGENDA
LOT 1 — nosači FN panela PV-1..PV-4 (po 3 × 585 Wp, položeno, 45°, azimut 225° JZ) — 2 stringa × 6
LOT 1 — AB temeljne trake 500 × 2600 mm, dubina 900, razmak 1600 mm
LOT 1 — DC trasa u PEHD Ø50 do PVDB
LOT 2 — DEA 18 kVA u skid izvedbi i dvoplašni spremnik 500 l
LOT 2 — usisna žaluzina (SI); kanal, žaluzina i izduv (SZ); ventilator (JI)
NAPOMENE:
1 Nosači i temelji prema tehničkom rješenju Ponuđača.
2 Temelji izvan ograde; ivice panela +0,50 / +2,93 m.
3 Zahtjevi: Prilog I, Tačke 3 i 4.
