ruledicaprio/solar-rfp-engine/rfp-hybrid-solar-td/TD-OUTPUT/grafika/hamzici/H-04.dxf

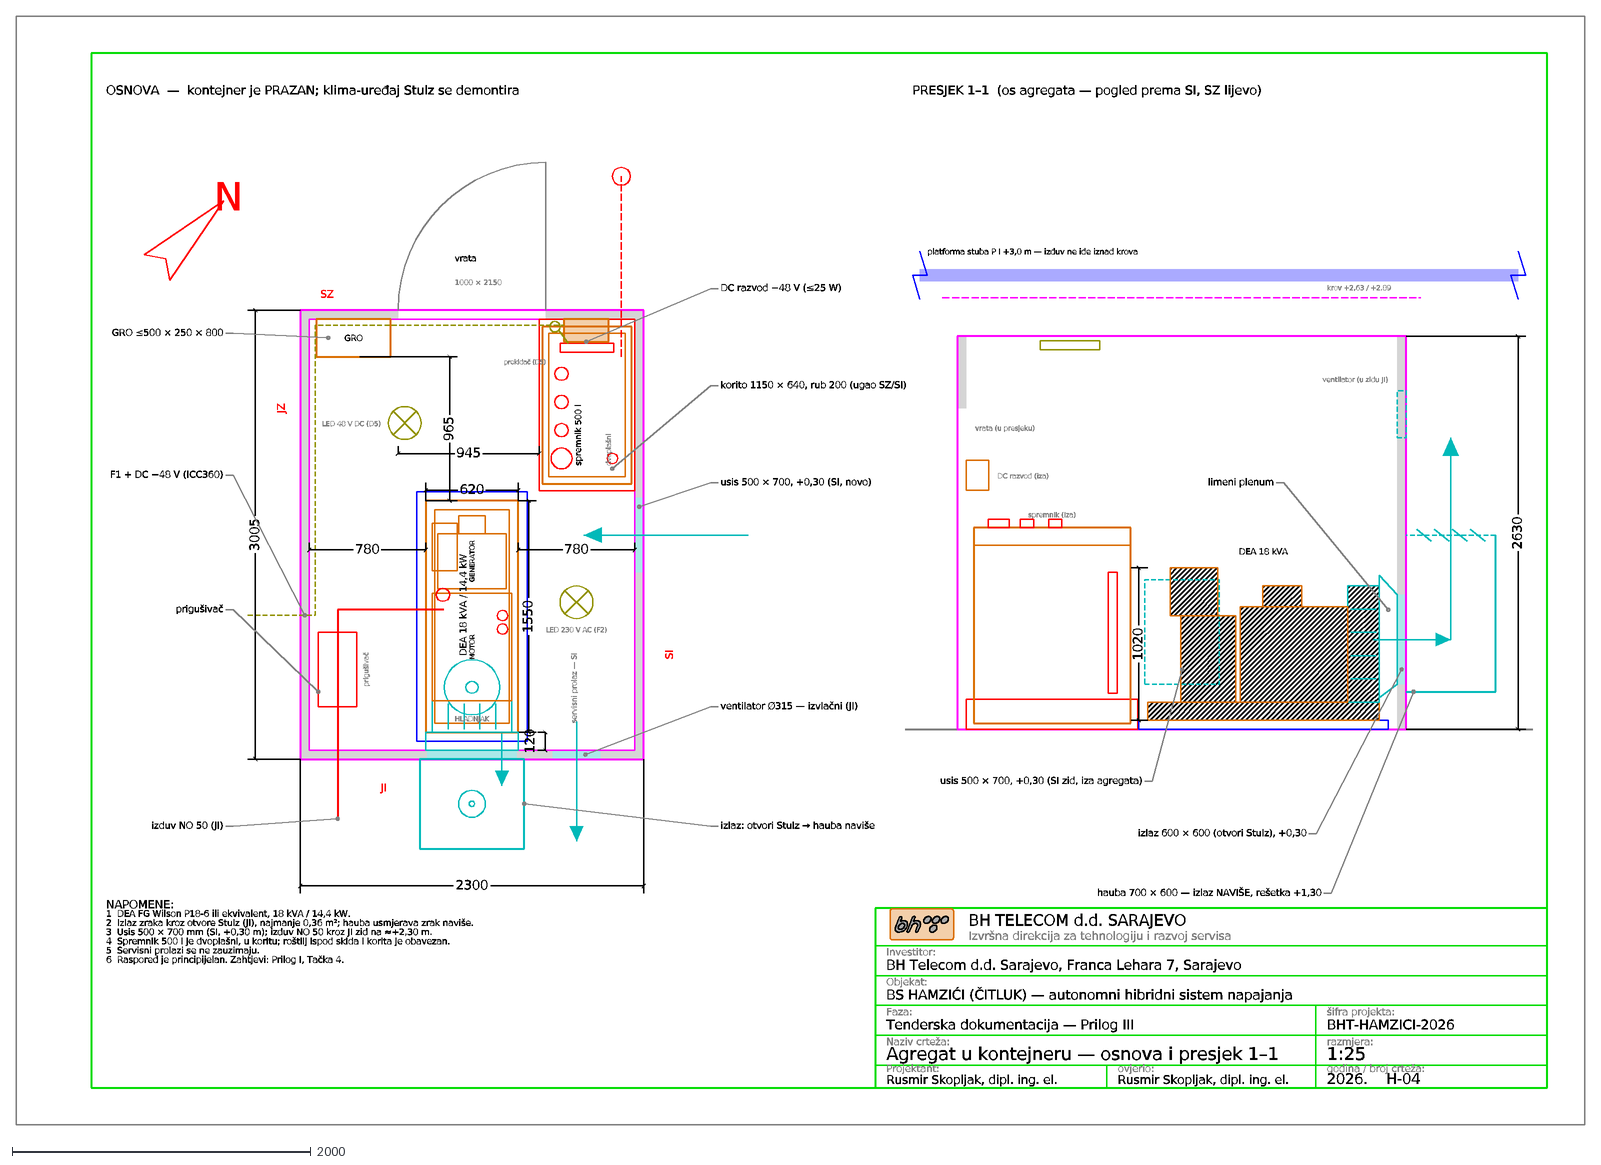
[picture p25: CAD file, 2026-10-05]
rfp-hybrid-solar-td/TD-OUTPUT/grafika/hamzici/H-04.dxf
BH TELECOM d.d. SARAJEVO
Izvršna direkcija za tehnologiju i razvoj servisa
Investitor:
BH Telecom d.d. Sarajevo, Franca Lehara 7, Sarajevo
Objekat:
BS HAMZIĆI (ČITLUK) — autonomni hibridni sistem napajanja
Faza:
Tenderska dokumentacija — Prilog III
šifra projekta:
BHT-HAMZICI-2026
Naziv crteža:
Agregat u kontejneru — osnova i presjek 1–1
razmjera:
1:25
Projektant:
Rusmir Skopljak, dipl. ing. el.
ovjerio:
godina / broj crteža:
2026. H-04
vrata
1000 × 2150
MOTOR
GENERATOR
1550
620
LED 230 V AC (F2)
LED 48 V DC (D5)
prekidač (D5)
DEA 18 kVA / 14,4 kW
HLADNJAK
spremnik 500 l
dvoplašni
GRO
prigušivač
servisni prolaz — SI
SZ
JI
JZ
SI
2300
3005
780
120
945
965
GRO ≤500 × 250 × 800
F1 + DC −48 V (ICC360)
izduv NO 50 (JI)
DC razvod −48 V (≤25 W)
korito 1150 × 640, rub 200 (ugao SZ/SI)
usis 500 × 700, +0,30 (SI, novo)
ventilator Ø315 — izvlačni (JI)
izlaz: otvori Stulz → hauba naviše
N
OSNOVA — kontejner je PRAZAN; klima-uređaj Stulz se demontira
1020
DEA 18 kVA
platforma stuba P I +3,0 m — izduv ne ide iznad krova
krov +2,63 / +2,89
spremnik (iza)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
