ruledicaprio/solar-rfp-engine/bht-sjednica-final-review/TD-OUTPUT/grafika/E-01.pdf

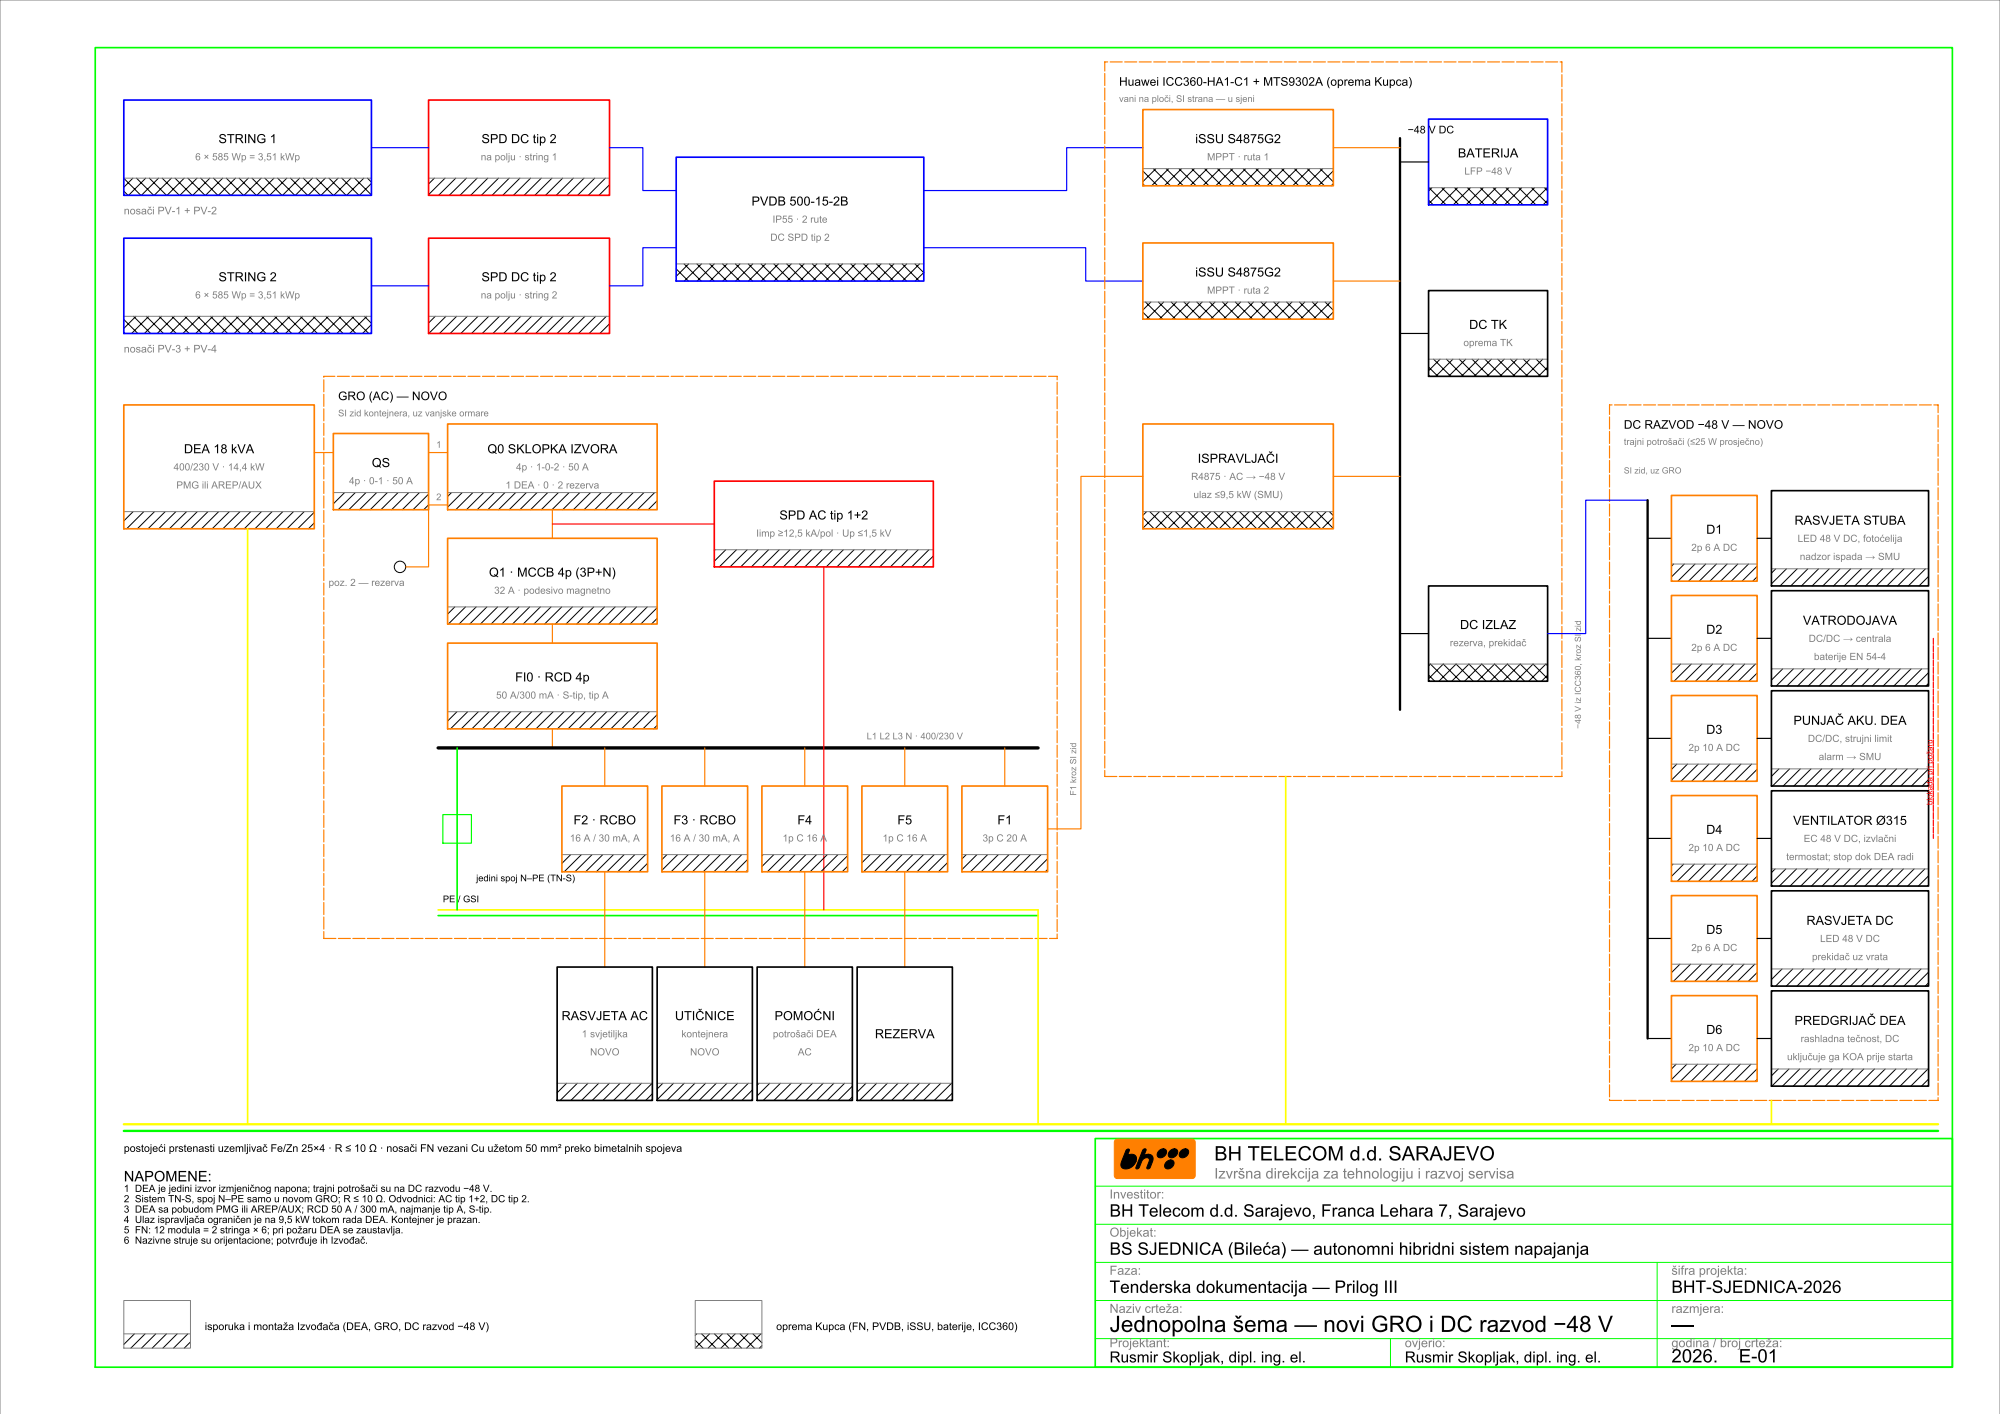
[picture p26: page 1]
