ruledicaprio/solar-rfp-engine/bht-sjednica-final-review/TD-OUTPUT/grafika/M-01.pdf

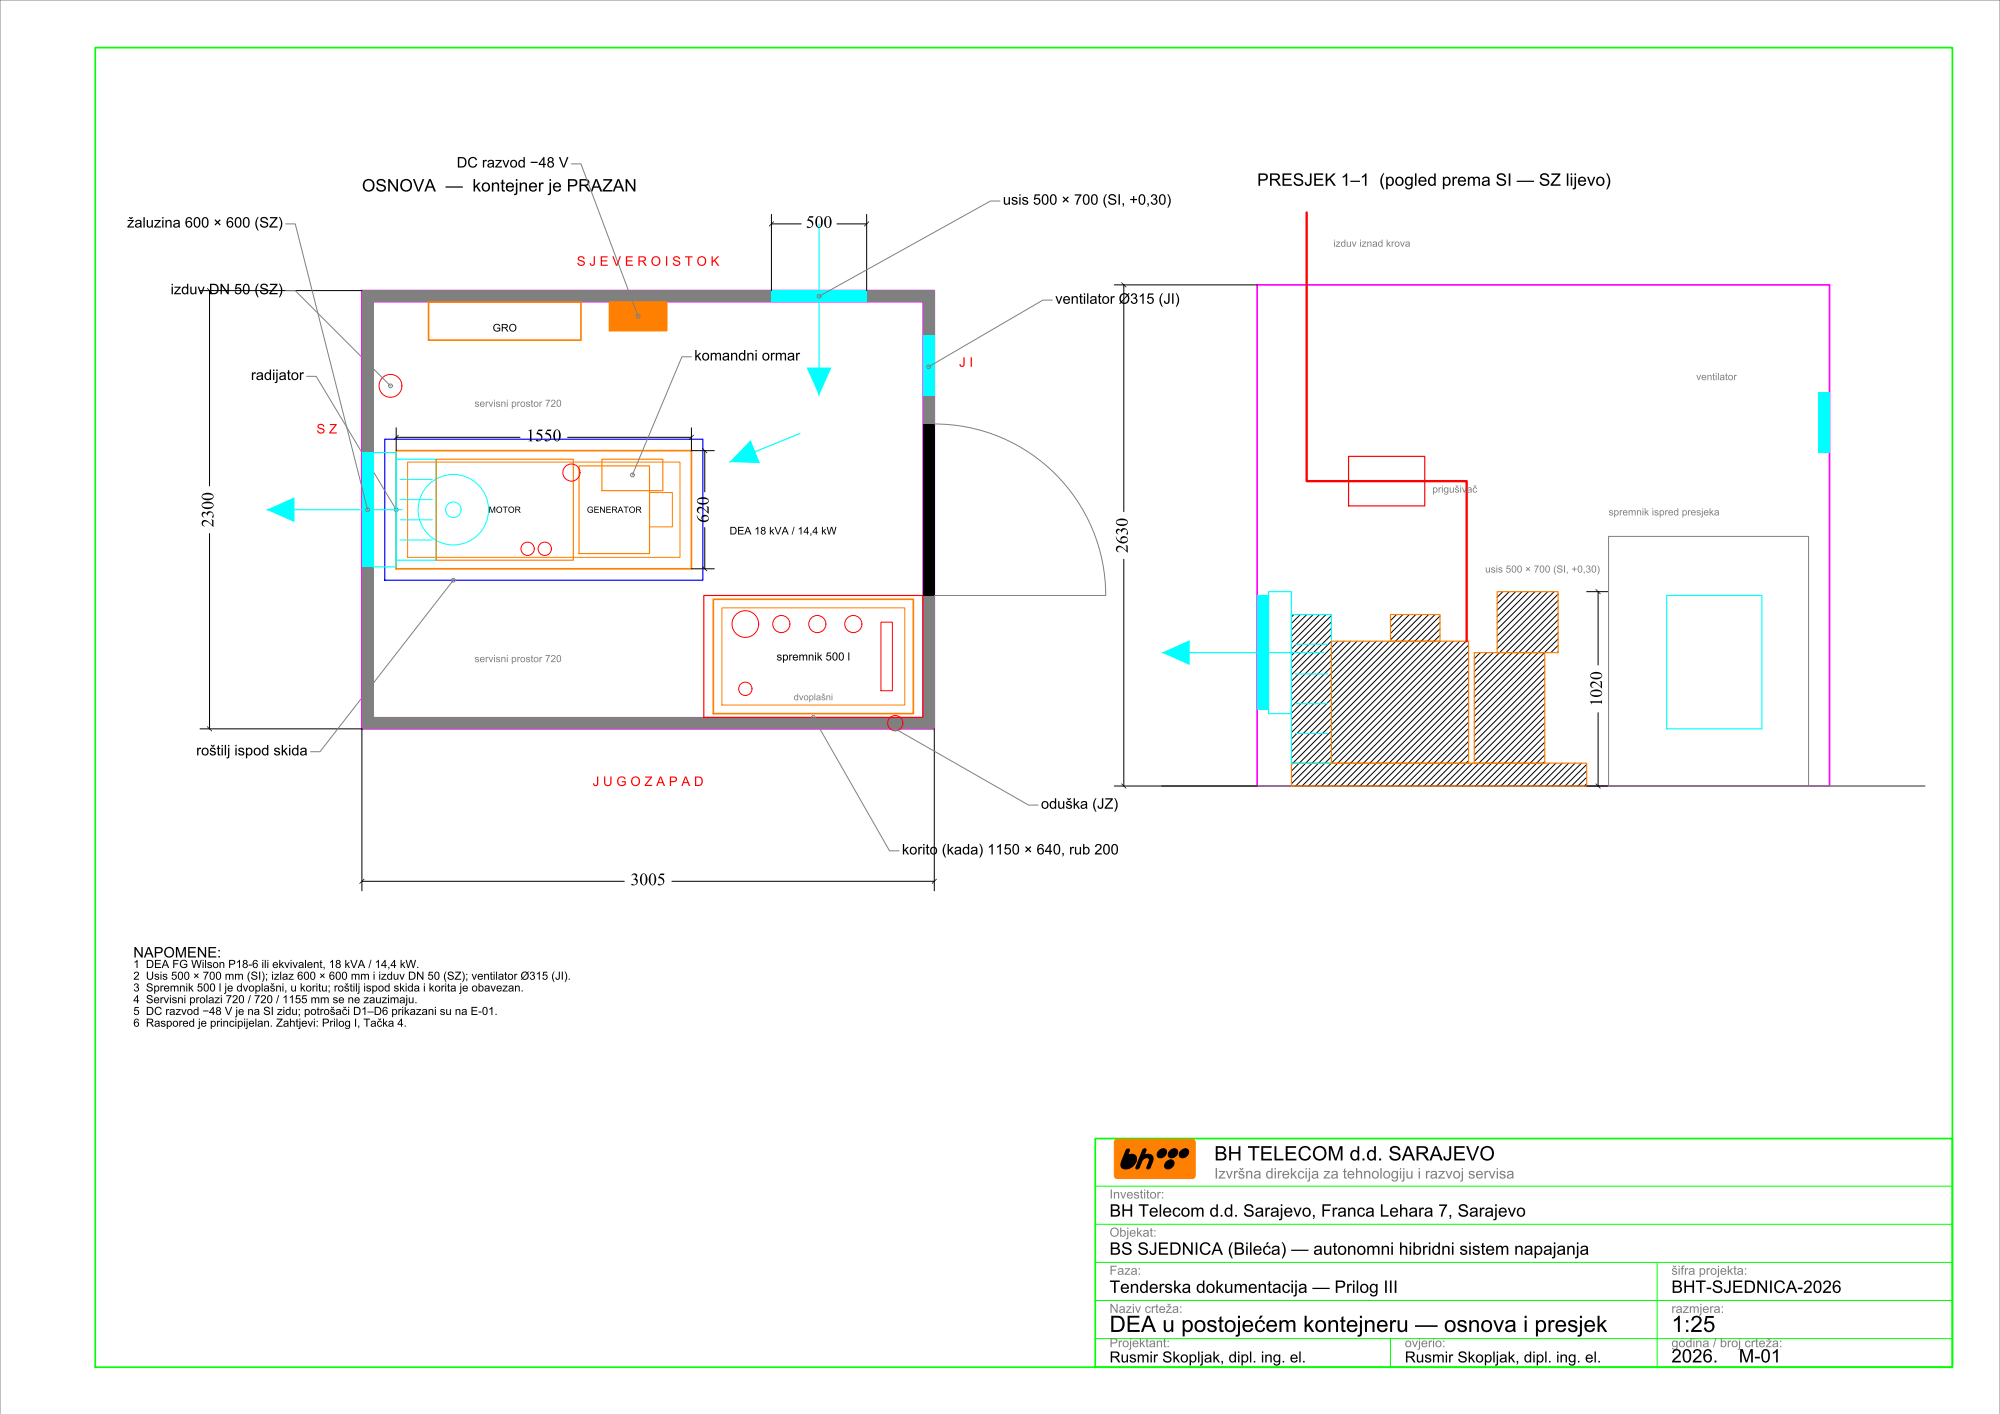
[picture p27: page 1]
