ruledicaprio/solar-rfp-engine/bht-sjednica-final-review/TD-OUTPUT/grafika/S-01.pdf

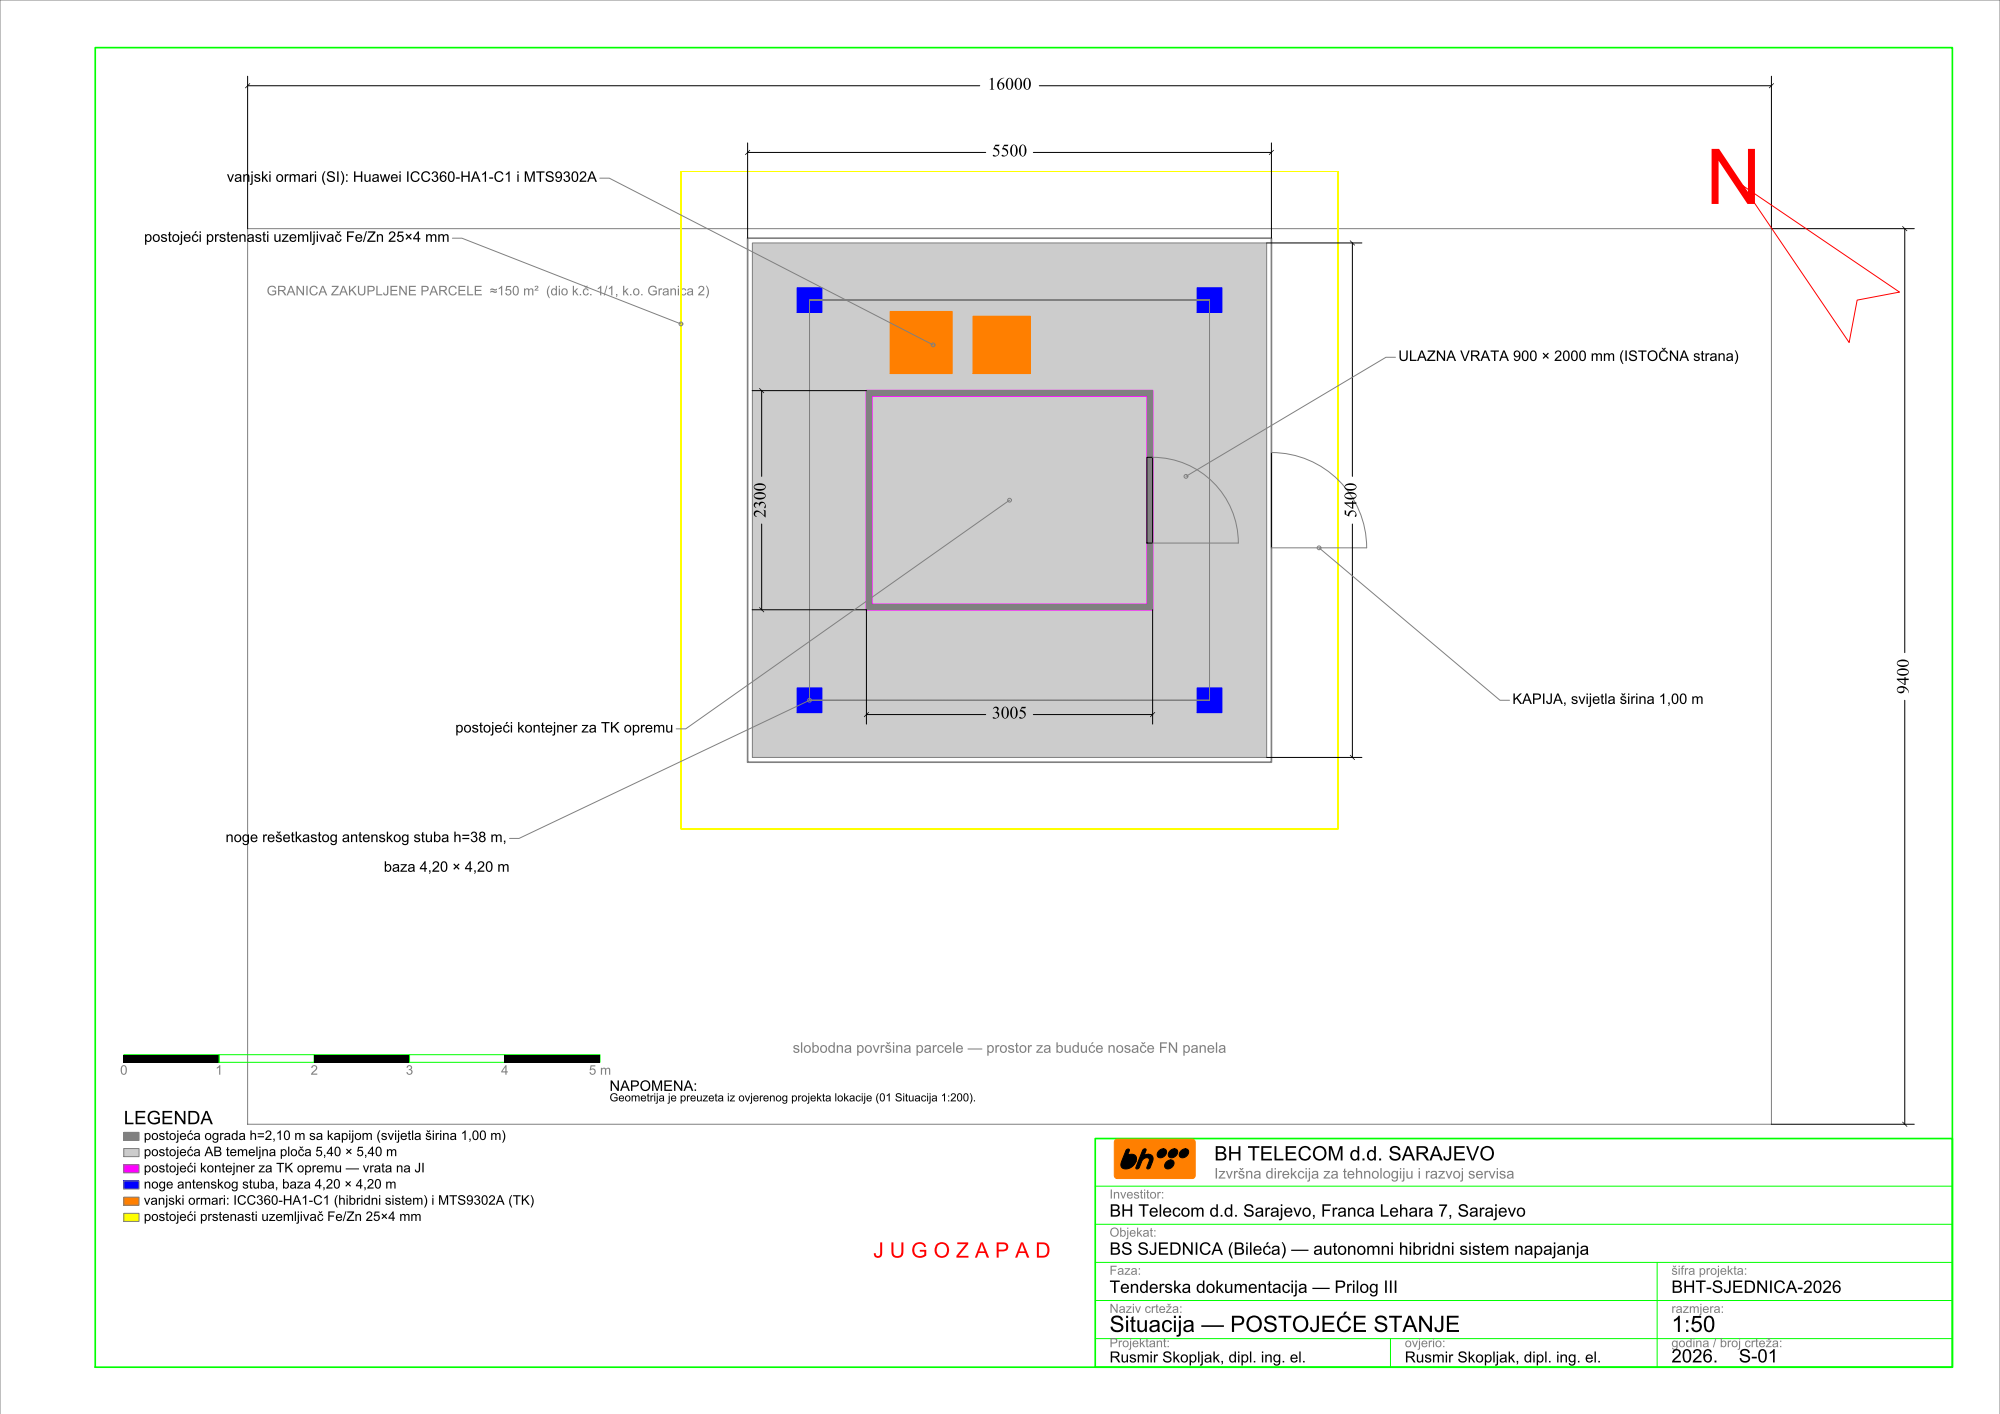
[picture p28: page 1]
