ruledicaprio/solar-rfp-engine/bht-sjednica-final-review/TD-OUTPUT/grafika/S-02.pdf

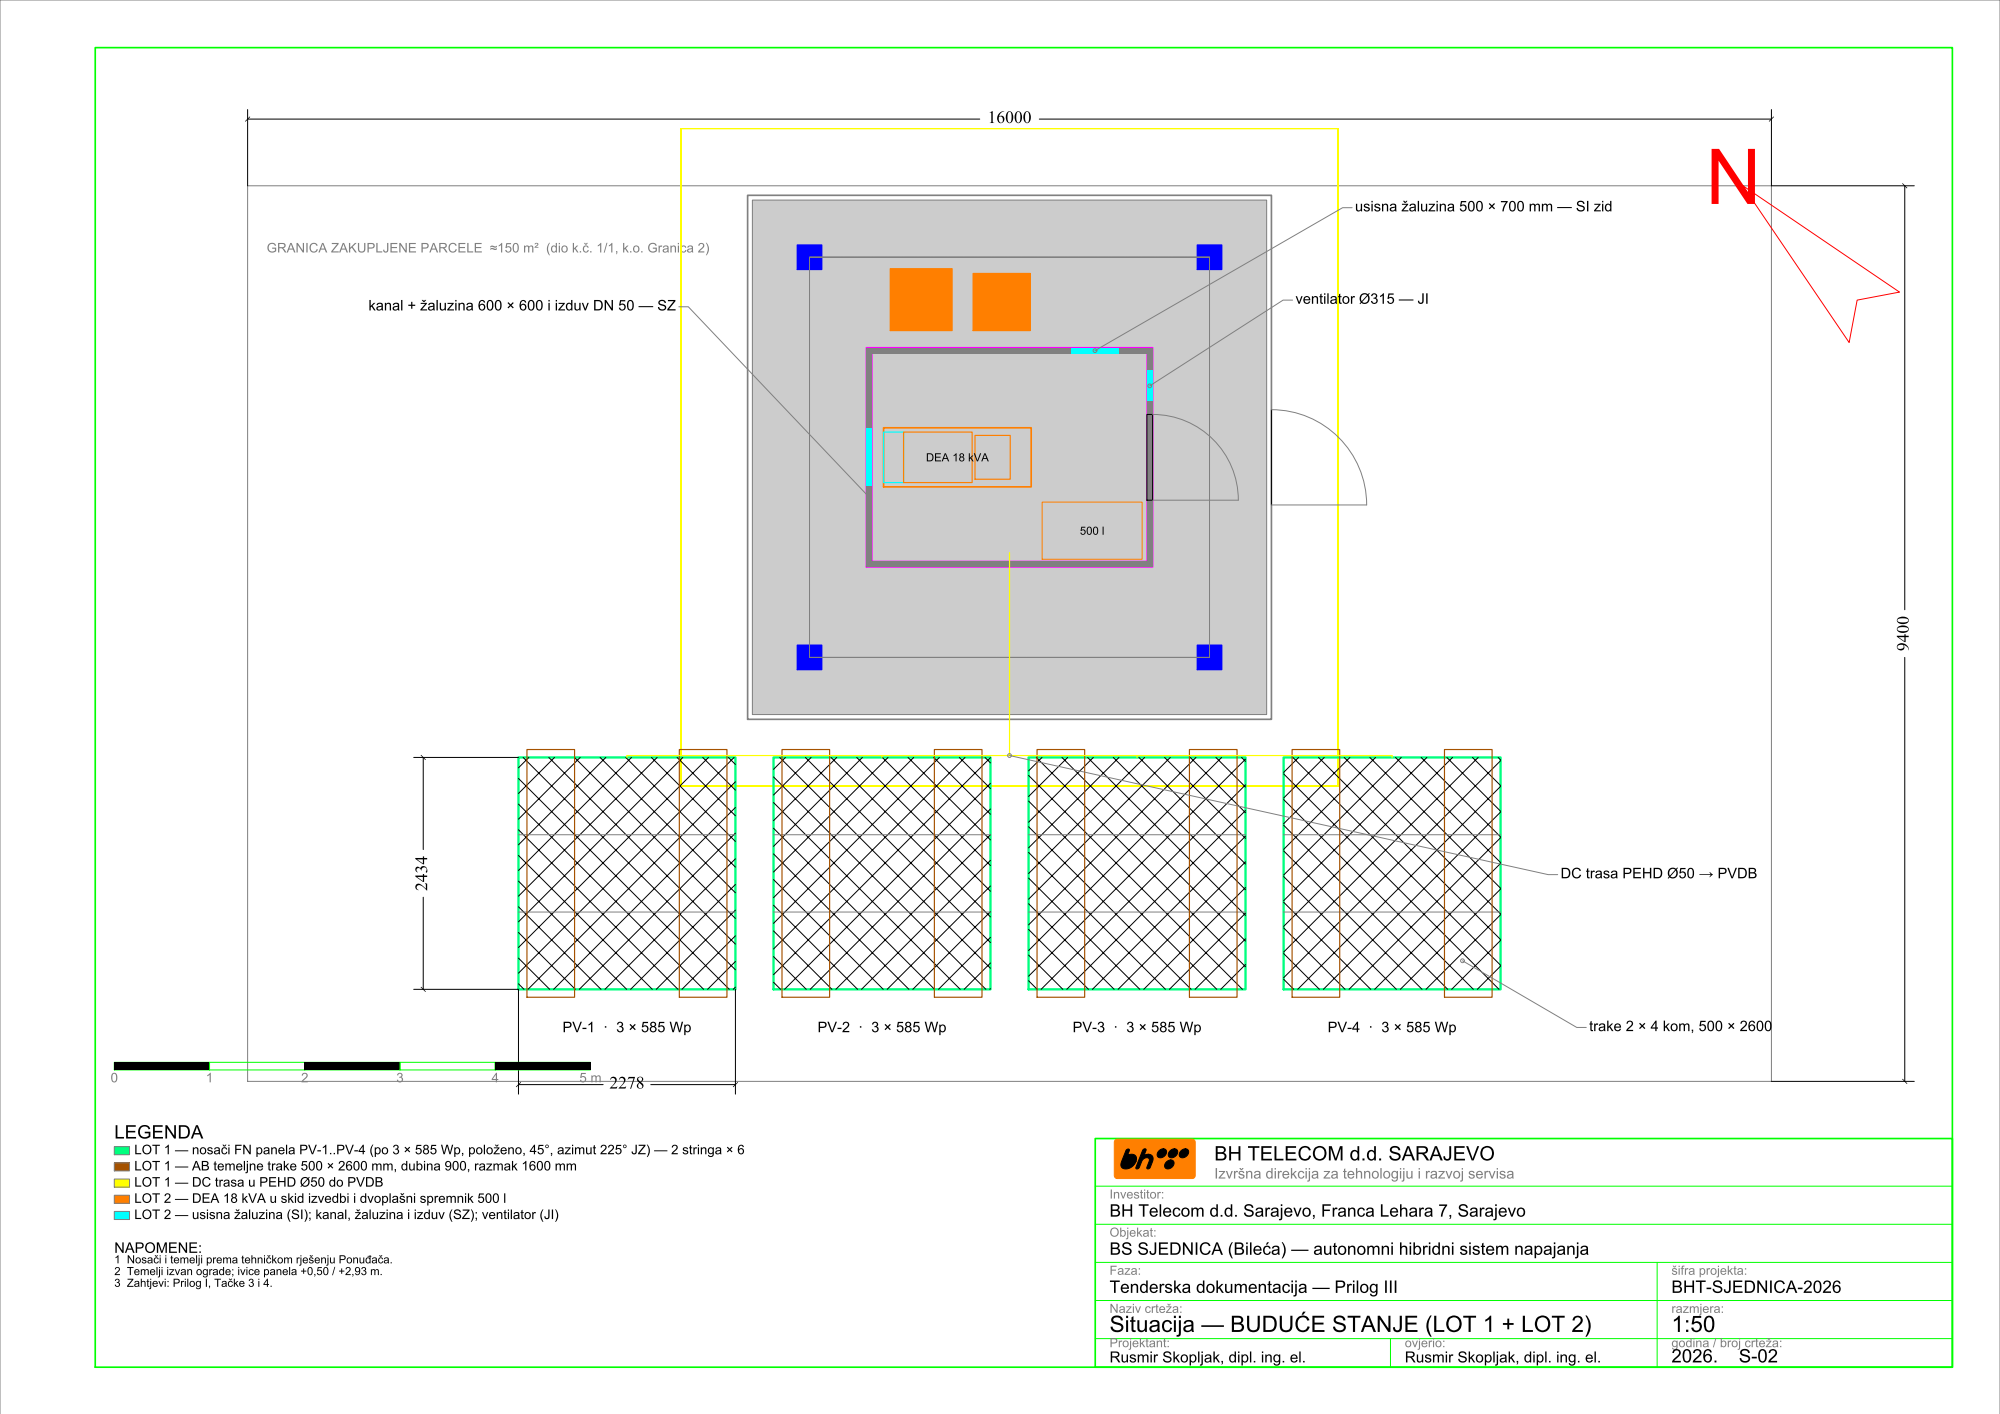
[picture p29: page 1]
