ruledicaprio/solar-rfp-engine/hamzici-hybrid-solar/TD-OUTPUT/grafika/H-01.pdf

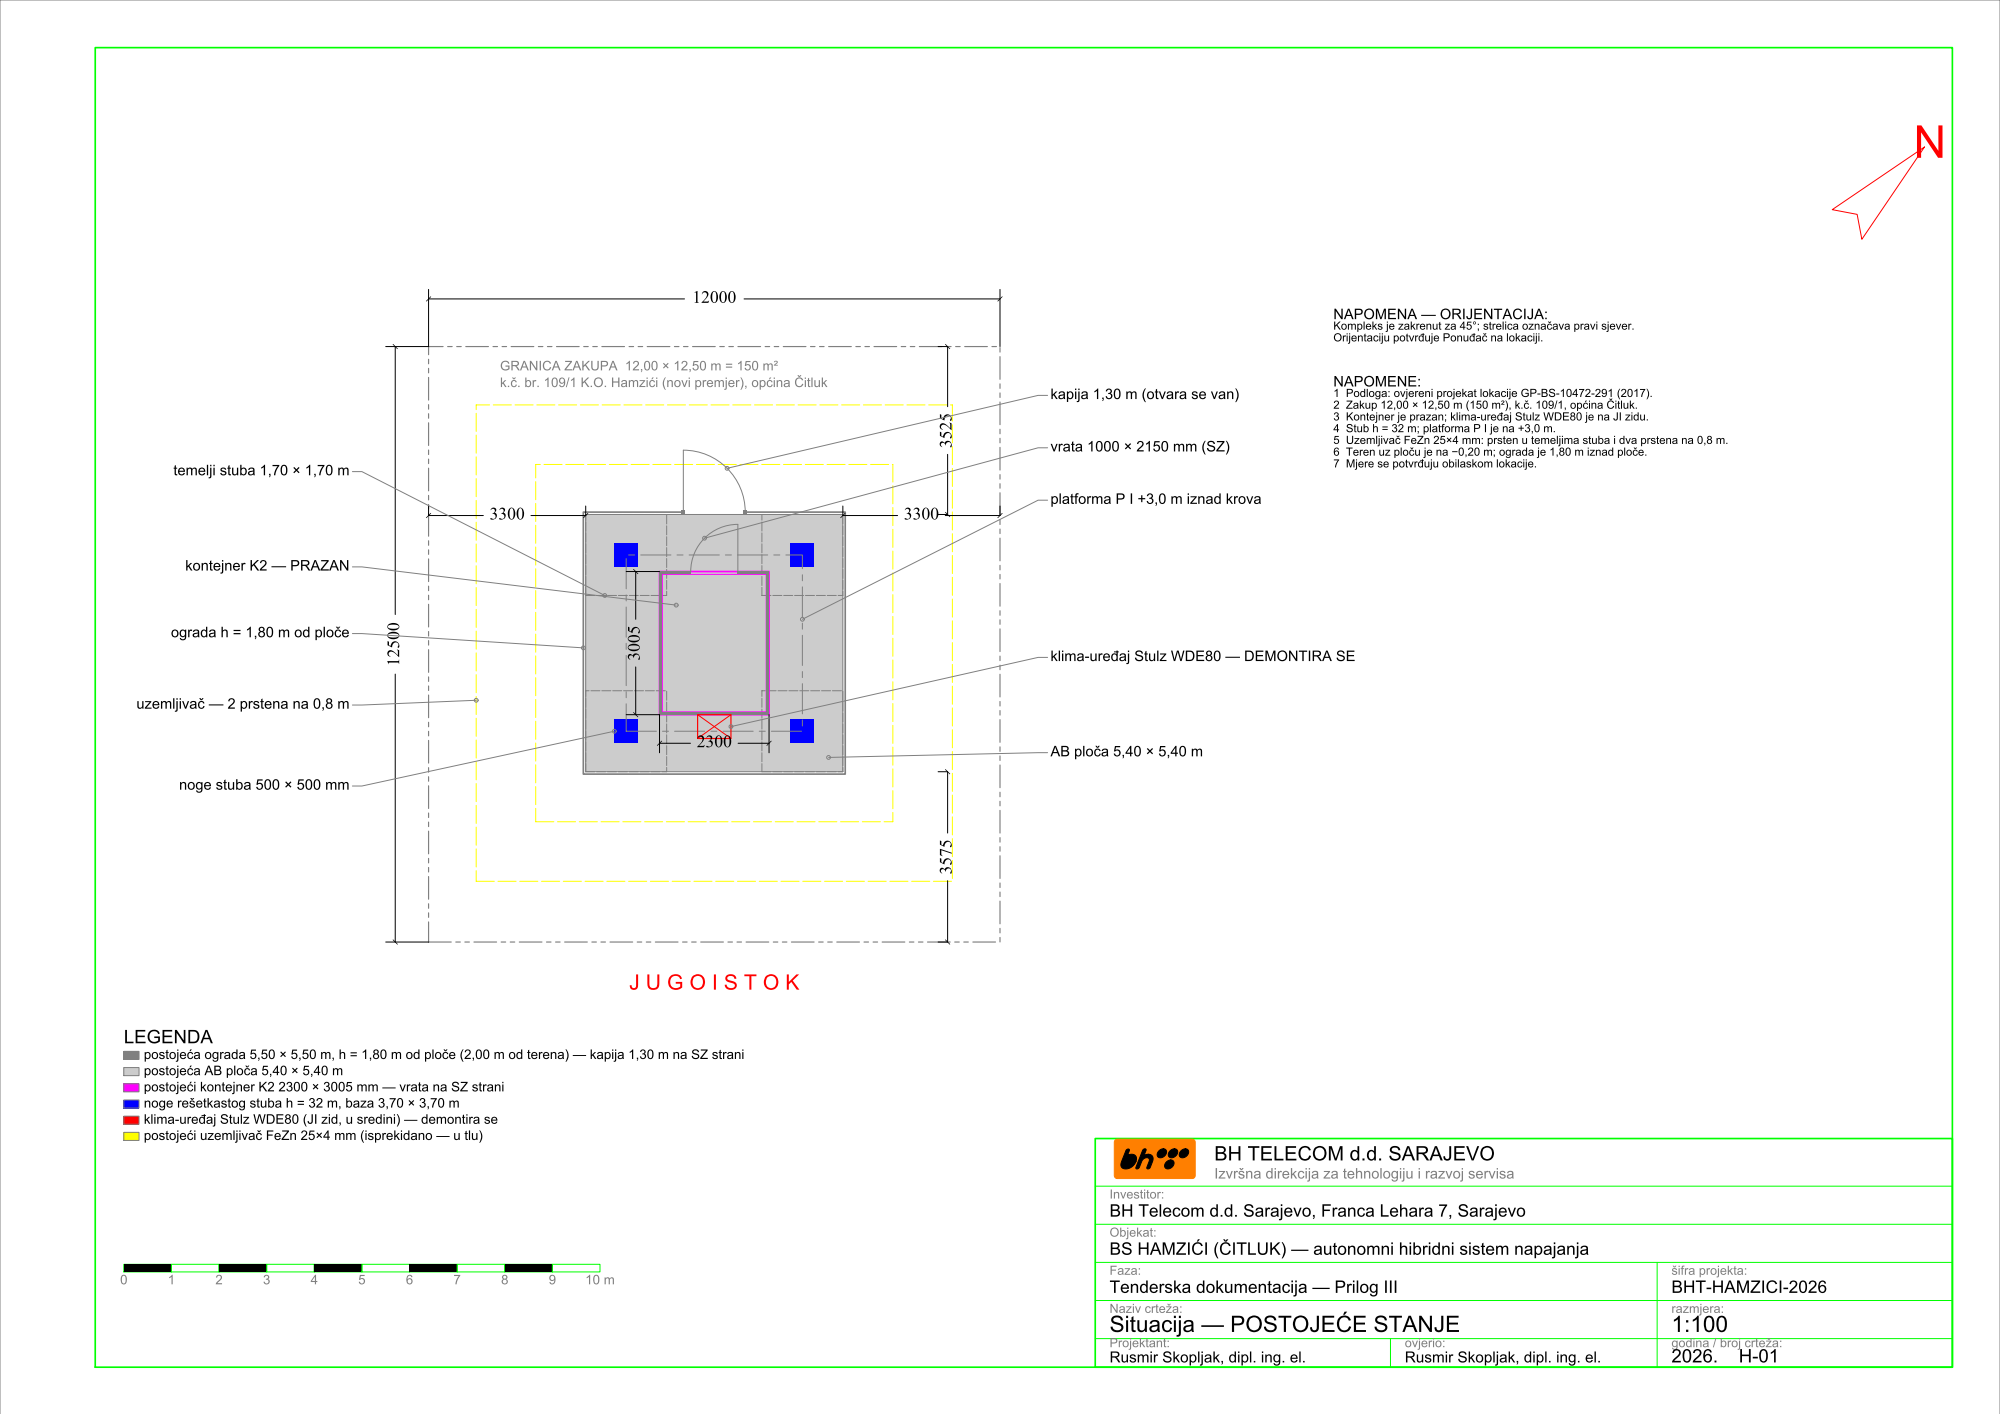
[picture p32: page 1]
