ruledicaprio/solar-rfp-engine/hamzici-hybrid-solar/TD-OUTPUT/grafika/H-02.pdf

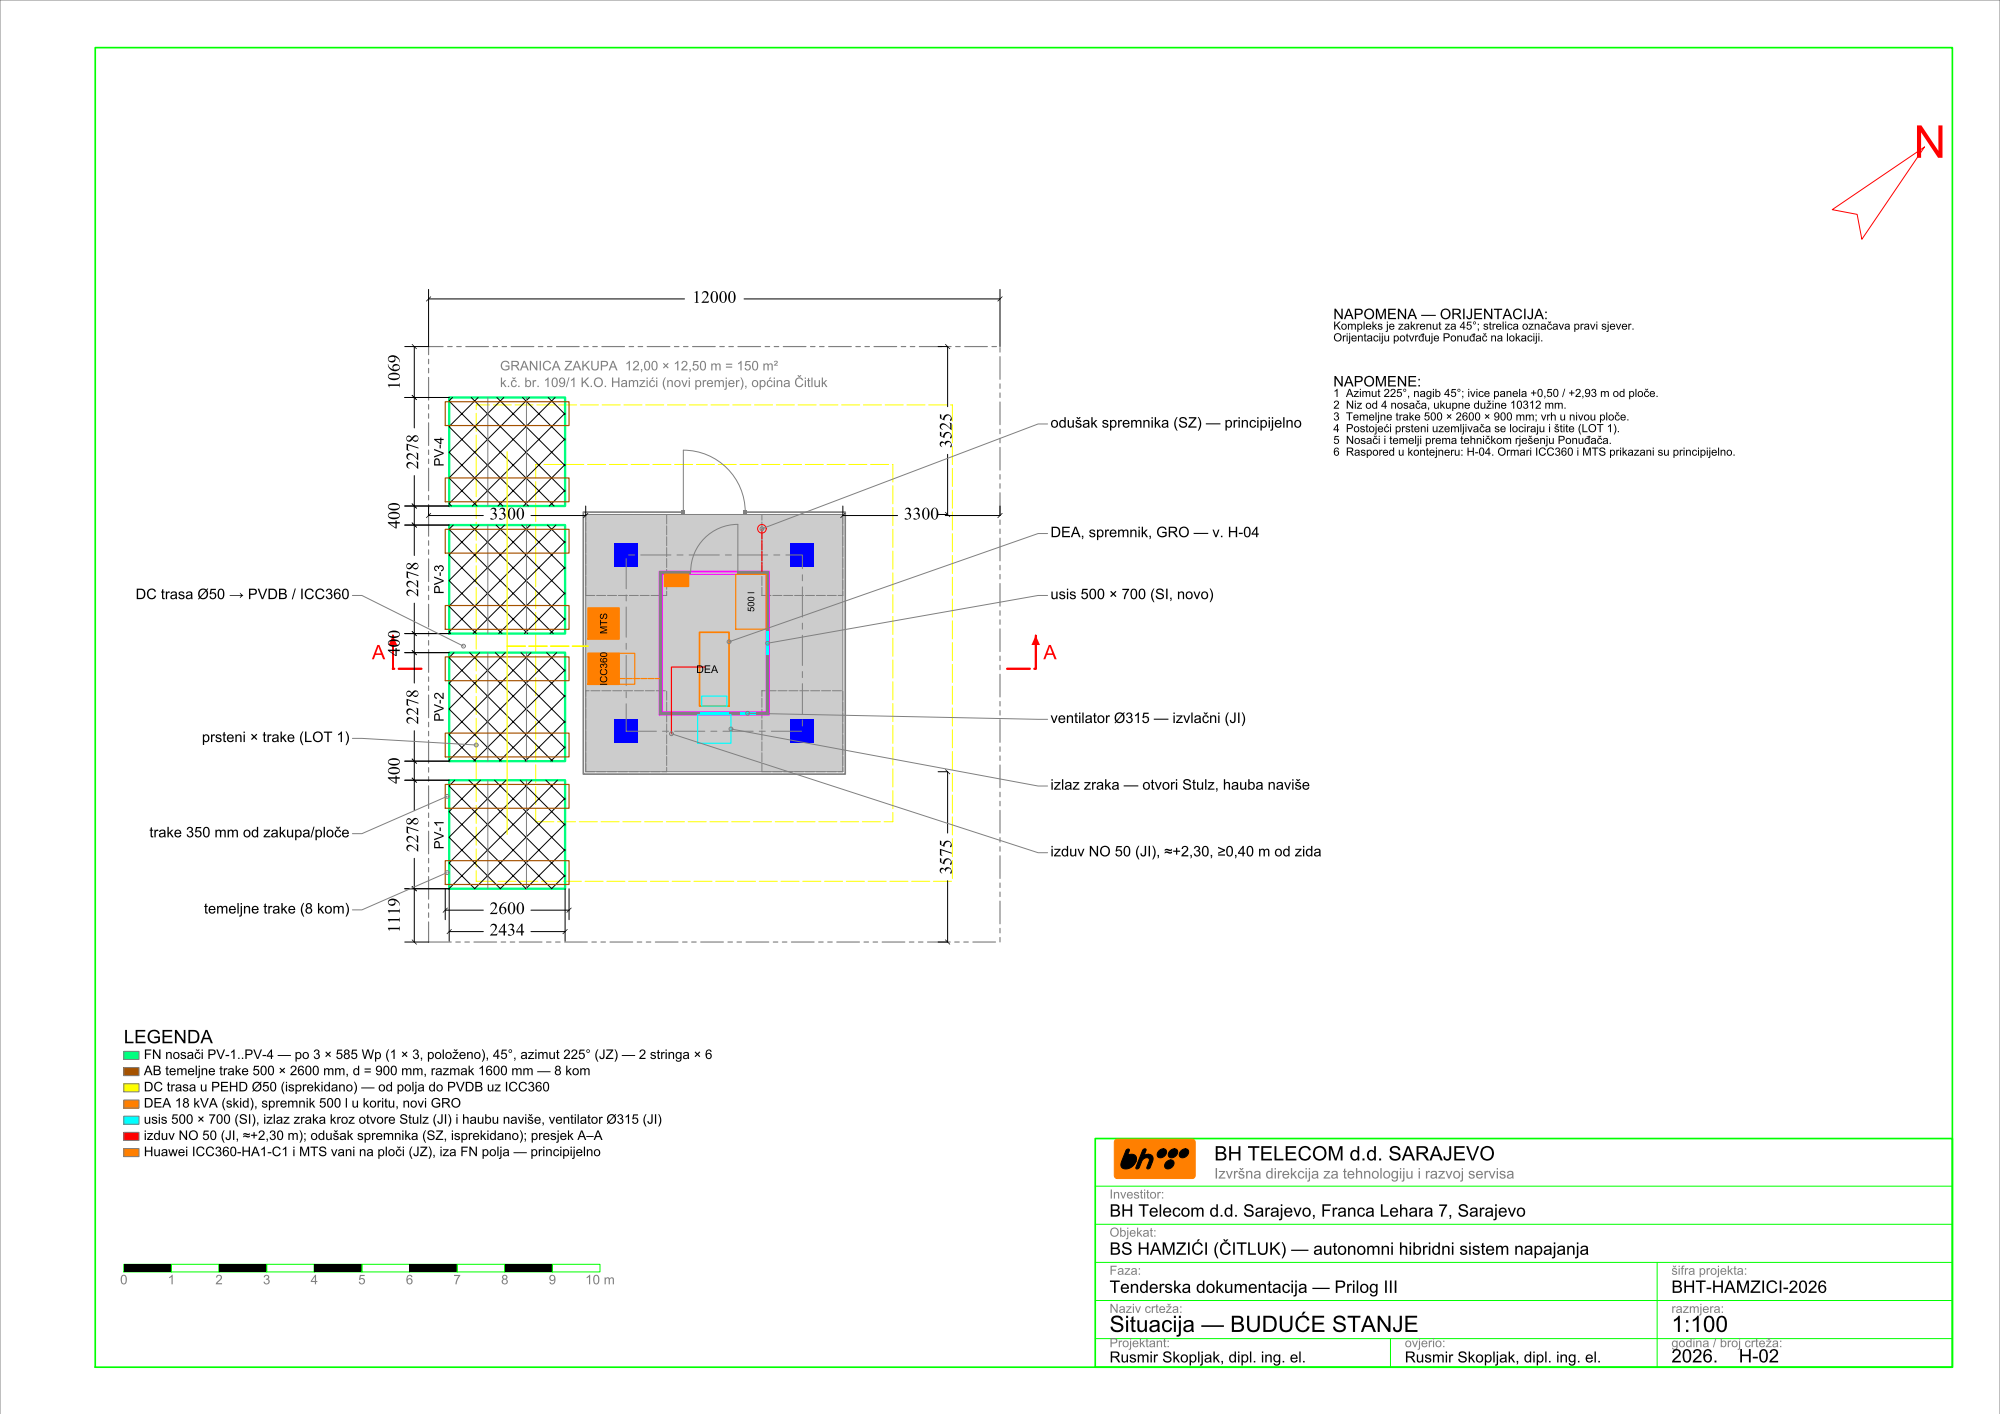
[picture p33: page 1]
