ruledicaprio/solar-rfp-engine/hamzici-hybrid-solar/TD-OUTPUT/grafika/H-03.pdf

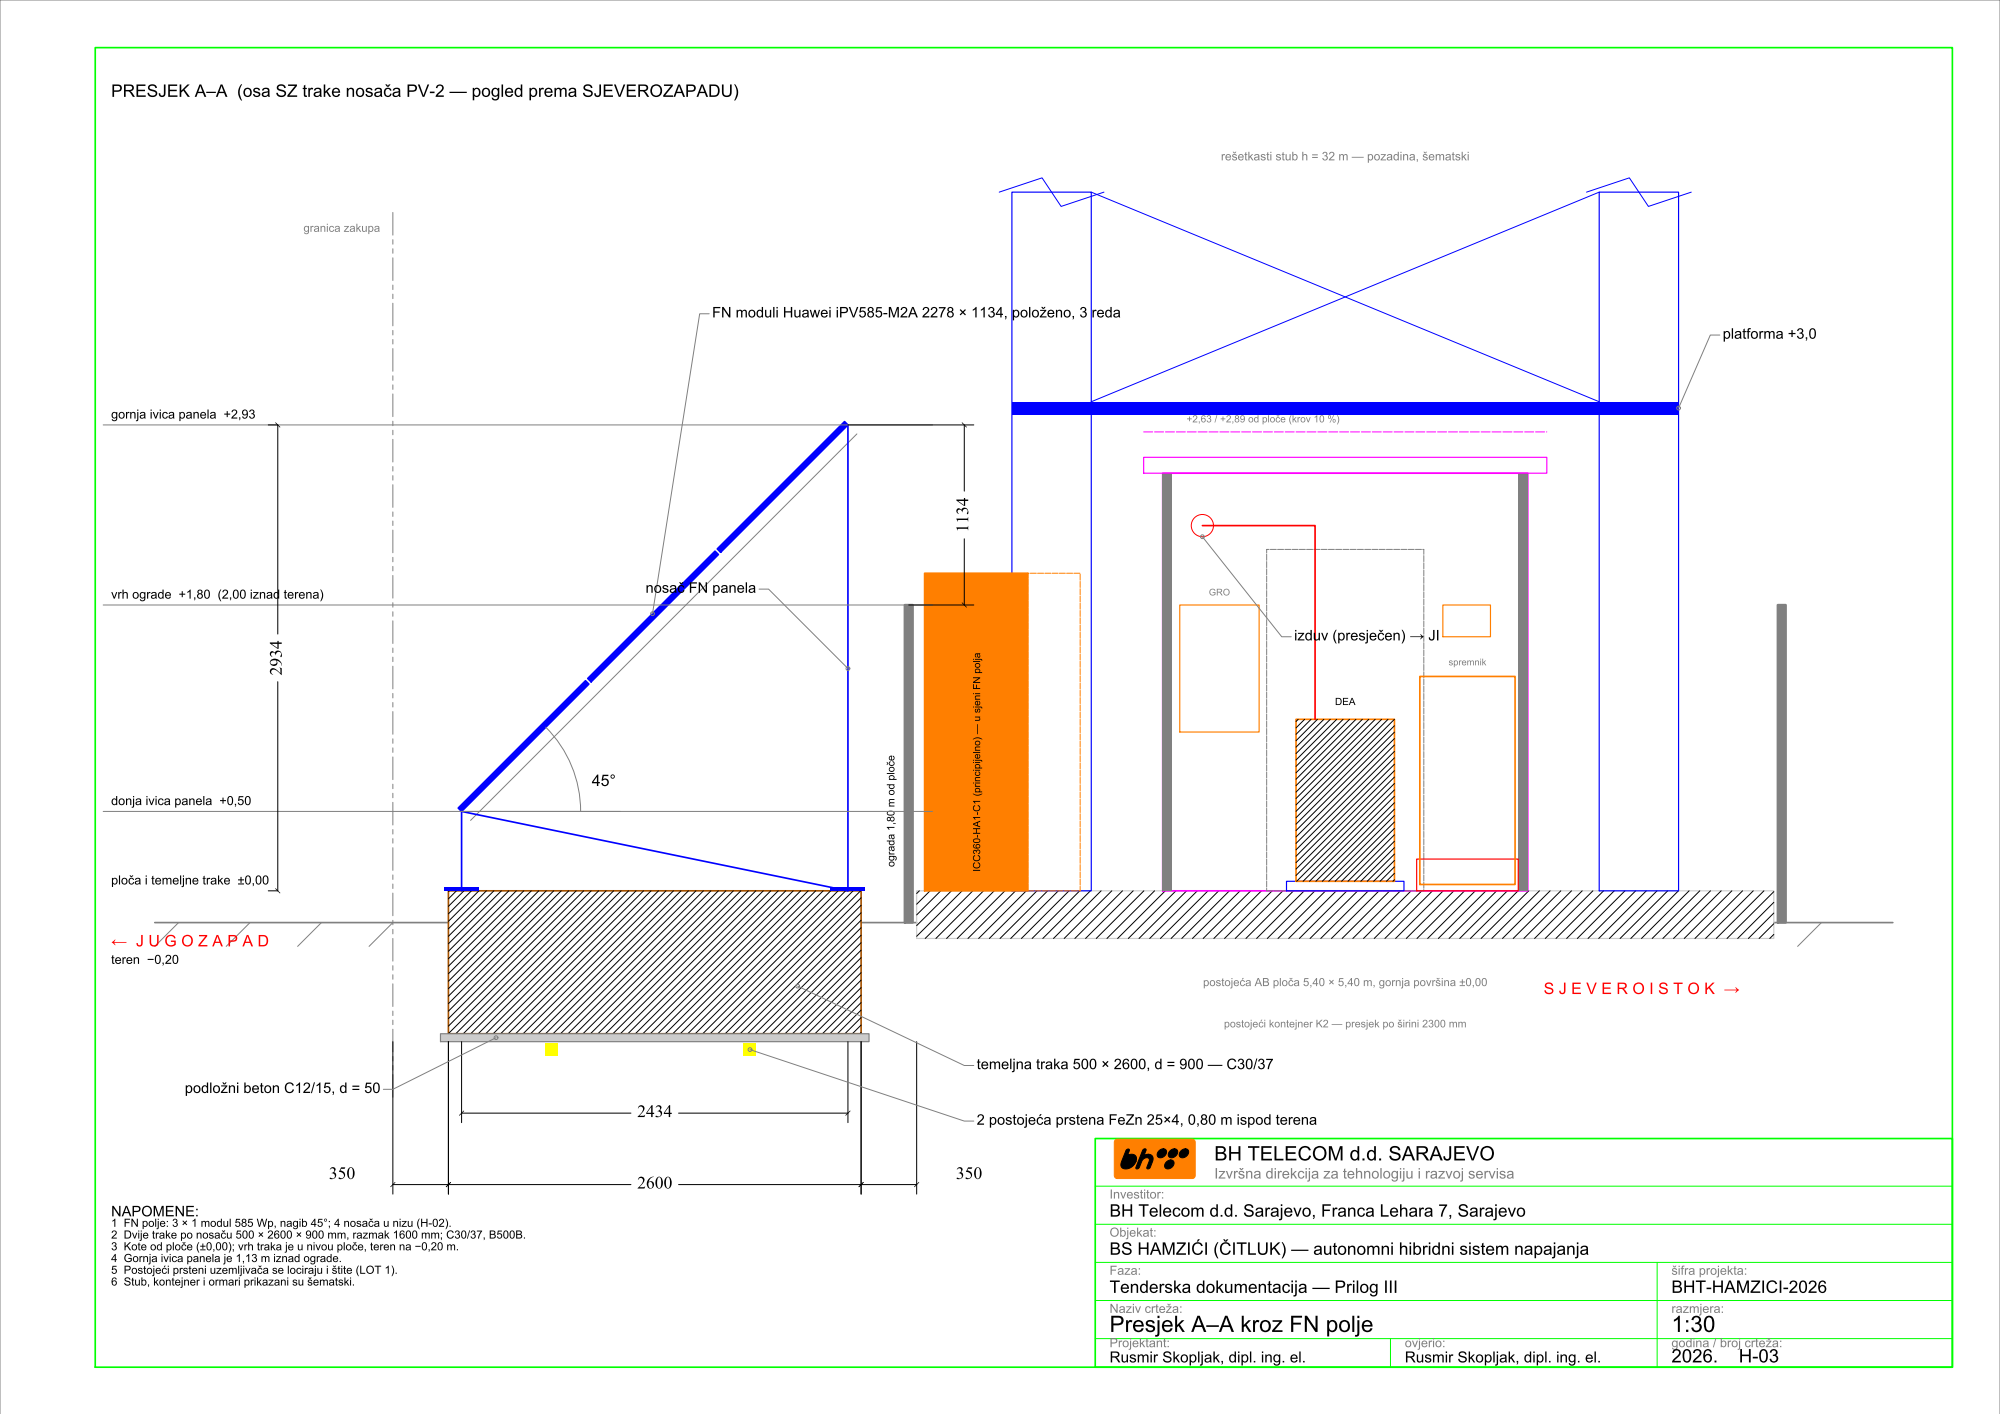
[picture p34: page 1]
