ruledicaprio/solar-rfp-engine/(commit log)

2026-09-12 pvsim reports at 45°, azimuth 225°, both sites
    Regenerated energetski-bilans, kpis, figures and CSVs for the true-SW 4x3L array: Sjednica 299 h / 988 l, Hamzići 273 h / 903 l.
    [monthly_t45.csv, monthly_t60.csv, years_t45.csv, years_t60.csv]
2026-09-12 Sjednica: true 45° orientation, 4 x 1x3 landscape stands, DC distribution
    Plan north = true NE; wall names in true directions; S-01..S-03 with the rotated north arrow and 4 separate 1x3 landscape stands, 8 strip footings; M-01/E-01 with the -48 V DC distribution D1-D6; BOQ LOT 1/2 through fix_boq_sw_4x3l.py; 07-proracuni, 09 decision record and change log updated.
    [3.1 PRILOG II TD - predmjer Sjednica Bileca.xlsx, E-01.dwg, E-01.dxf, M-01.dwg, M-01.dxf, S-01.dwg, S-01.dxf, S-02.dwg]
2026-09-12 Hamzići: true orientation, 4x3L stands in the SW band, container re-laid
    Plan north = true NW; stands, ICC360 and MTS in the 3,30 m true-SW band; radiator and hood on JI, intake on SI, tank tray SZ/SI, exhaust via JI; H-01..H-05 rebuilt with site checks; 07-proracuni Rev 2.
    [H-01.dwg, H-01.dxf, H-02.dwg, H-02.dxf, H-03.dwg, H-03.dxf, H-04.dwg, H-04.dxf]
2026-09-12 Joint TD rebuilt for SW 4x3L at both sites
    Prilog I, Odluka limits (~300 / ~270 h, ~990 / ~900 l), BOQ texts and quantities, drawings and calculation PDFs regenerated; checkers updated (rules_joint, build_joint, check_boq_recalc).
    [3.1 PRILOG II TD - predmjer Sjednica i Hamzici.xlsx, E-01.dwg, E-01.dxf, H-01.dwg, H-01.dxf, H-02.dwg, H-02.dxf, H-03.dwg]
2026-09-12 TD: estimate 100 000 KM, one Prilog II price form per LOT
    Investor 12.09.2026: 100 000,00 KM bez PDV-a, LOT 1 30 000,00 KM, LOT 2 70 000,00 KM. The NZ and the Odluka keep the amounts instead of placeholders; the amount in words is corrected to "sto hiljada", the Odluka's 50 000 / 15 000 / 35 000 figures and its 50.000 table total become 100 000 / 30 000 / 70 000, and the "LOT 1a iznos" typo is fixed. rules_joint checks the amounts instead of reporting them pending.
    Prilog II is split into one workbook per LOT (LOT n Sjednica, LOT n Hamzići, REKAPITULACIJA LOT n with its own discount, 17 % VAT, notes, date and signature), because the award is per LOT and a bidder may offer one LOT only. The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
    [3.1 PRILOG II TD - Obrazac za cijenu ponude LOT 1 - Sjednica i Hamzici.xlsx, 3.1 PRILOG II TD - Obrazac za cijenu ponude LOT 2 - Sjednica i Hamzici.xlsx, 3.1 PRILOG II TD - predmjer Sjednica i Hamzici.xlsx]
2026-09-14 Temeljna traka jedinstvenog presjeka; masa nosača se ne zadaje
    Recenzija A. Čolpa, 27.08.2026 (proračun Sjednica, str. 4):
    B.6 "U stijeni je širi temelj u dnu jako teško izvesti. Predlažem da se
    dimenzija dole izbaci." — traka 400/500 postaje 500 mm po cijeloj
    dubini. Rov se u stijeni siječe jednom širinom; temelj širi u dnu
    tražio bi potkopavanje. Zapremina 1,053 -> 1,170 m3 po traci,
    8,42 -> 9,36 m3 po lokaciji; dokaz na podizanje se popravlja
    (0,9 x 28,1 = 25,3 kN prema sprezi 16,1 kN). Rov je sada u cijelosti
    ispunjen betonom i podložnim betonom, pa zatrpavanja nema.
    B.3 "110 kg po jednom nosaču je jako malo. Predlažem brisanje procjenjene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
    [E-01.dxf, H-01.dxf, H-02.dxf, H-03.dxf, H-04.dxf, H-05.dxf, M-01.dxf, S-01.dxf]
2026-09-14 Predmjer i Prilog I po komentarima recenzenta iz predmjera
    Recenzija A. Čolpa, 27.08.2026 (komentari u predmjeru Sjednica). Komentari su
    dati na reviziju sa 3 nosača 2x2 portret; ovdje su primijenjeni na usvojeni
    raspored.
    1.1 "...ponuđač obavezan da uz ponudu dostavi tehničko rješenje konstrukcije
    za prihvat fotonaponskih panela sa obaveznim statičkim proračunom i
    specifikacijom materijala za predmetnu lokaciju." — novi stav UZ PONUDU;
    dokaz 2 u Tački 5 Priloga I proširen na tehničko rješenje.
    1.2 "Treba izbjeći navođenje vrijednosti sila čupanja i podizanja, te momenata
    prevrtanja... ponuđači će nuditi različite koncepte konstrukcije." —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
    [3.1 PRILOG II TD - Obrazac za cijenu ponude LOT 1 - Sjednica i Hamzici.xlsx, 3.1 PRILOG II TD - Obrazac za cijenu ponude LOT 2 - Sjednica i Hamzici.xlsx, 3.1 PRILOG II TD - predmjer Sjednica Bileca.xlsx, E-01.dxf, H-01.dxf, H-02.dxf, H-03.dxf, H-04.dxf]
2026-09-14 Odgovor recenzentu na komentare od 27.08.2026
    Jedan dokument po komentaru: doslovan citat, šta je konkretno izmijenjeno i
    gdje se to vidi. Devet komentara (sedam u predmjeru, dva u proračunu), svi
    usvojeni.
    Dva mjesta traže njegovu potvrdu i izričito su tako i postavljena:
    - qp >= 1,20 kN/m2 i cf zadržani su u Prilogu I 3.2 kao podatak lokaliteta
    iz ovjerene dokumentacije (nisu rezultat ponuđačevog koncepta), a izvedene
    sile po nosaču su tamo označene kao orijentacione;
    - od dvije kote trake usvojena je veća (500 mm), pa su uz nju date i količine
    za varijantu 400 mm, sa dokazom na podizanje za obje.
2026-09-14 Preuzimanje i transport opreme Kupca u LOT 2; pregled Priloga I i III
    Transport opreme Kupca. TD JN opremu hibridnog sistema vodi kao posebnu
    nabavku, a Prilog II 5.14 to ponavlja, ali nijedan dokument nije rekao ko je
    preuzima iz skladišta i dovozi na lokaciju. Ponuđač je mogao ponuditi čitav
    LOT 2 i s pravom odbiti prevoz. Dodato kao obaveza u LOT 2 na obje lokacije:
    Prilog I 4.9 preuzimanje u skladištu Azići, Bojnička bb, Sarajevo; obuhvat,
    vozilo, rukovanje, najava 3 radna dana, dokumenti, odgovornost
    Prilog I 5/14 otpremnica i zapisnik o preuzimanju, po lokaciji
    Prilog II 5.19 novi red na OBA lista LOT 2 (kpl x 1)
    Prilog III red "Oprema Kupca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
    [3.1 PRILOG II TD - Obrazac za cijenu ponude LOT 1 - Sjednica i Hamzici.xlsx, 3.1 PRILOG II TD - Obrazac za cijenu ponude LOT 2 - Sjednica i Hamzici.xlsx, E-01.dxf, H-01.dxf, H-02.dxf, H-03.dxf, H-04.dxf, H-05.dxf]
2026-09-14 Pregenerisani proracuni, Prilog III i DWG izvozi
    [3.1 PRILOG II TD - Obrazac za cijenu ponude LOT 1 - Sjednica i Hamzici.xlsx, 3.1 PRILOG II TD - Obrazac za cijenu ponude LOT 2 - Sjednica i Hamzici.xlsx]
2026-09-14 Crteži: ventilator na S-02, šrafura opreme Kupca, kraće napomene
    S-02 Ventilator Ø315 je bio samo imenovan u izlazniku za SZ zid, a na JI zidu,
    gdje stvarno stoji, nije bilo oznake. Dodata oznaka na JI zidu i zaseban
    izlaznik, kao na M-01.
    E-01 Ormar DC −48 V prelazio je preko desne linije okvira (20 600 > 20 500) —
    pomjeren unutra. Ključ šrafure stajao je na tekstu napomena — sada je red
    ključeva uz donju ivicu, kao na H-05.
    Šrafura Granica isporuke se sada čita sa crteža na obje lokacije: jednostruke
    kose linije = isporuka i montaža Izvođača, unakrsna šrafura = oprema koju
    obezbjeđuje Kupac, a Izvođač je samo ugrađuje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
    [E-01.dxf, H-01.dxf, H-02.dxf, H-03.dxf, H-04.dxf, H-05.dxf, M-01.dxf, S-01.dxf]
2026-09-14 Prilog III: stranica fotografija u landscape, opšti podaci formalizovani
    Fotografije Hamzića. Stranica je sada A4 LANDSCAPE, a dvije fotografije stoje
    jedna uz drugu umjesto jedna ispod druge. Snimljene su uspravno a pohranjene
    zakrenute, pa je stub na dosadašnjoj stranici ležao poprijeko — sada se okreću
    za 90° i stub stoji. Traka sa oznakama koju `pvsim photo` dodaje uz donju ivicu
    (46 px) se odsijeca: okrenuta sa slikom išla bi uspravno uz bočnu ivicu, a šta
    se vidi piše u potpisu ispod slike.
    Opšti podaci o lokaciji, obje lokacije. Tabela nosi podatke, a ne komentare:
    izbačeni su izvori i usklađivanja sa drugim dokumentima („Google Maps, Naručilac
    11.09.2026", „proje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
    [E-01.dxf, H-01.dxf, H-02.dxf, H-03.dxf, H-04.dxf, H-05.dxf, M-01.dxf, S-01.dxf]
2026-09-14 Pregenerisan Prilog III i DWG izvozi
    [3.1 PRILOG II TD - Obrazac za cijenu ponude LOT 1 - Sjednica i Hamzici.xlsx, 3.1 PRILOG II TD - Obrazac za cijenu ponude LOT 2 - Sjednica i Hamzici.xlsx]
2026-09-15 Ujednačene jednopolne šeme; Prilog I i II po odluci Naručioca 15.09.2026
    Prilog I: uklonjene sve brojke dejstava i izvedene sile (qp, cf, sila podizanja,
    moment prevrtanja, spreg po traci) — dejstva usvaja Ponuđač prema standardima iz
    Tačke 2, a tačka 3.2 postaje "Tehničko rješenje nosive konstrukcije". Obrisani
    uvodni pasusi, kolona Napomena u 1.1 i izvođenje orijentacije iz Google Mapsa.
    Oba kontejnera se vode kao prazna. Tačke 4.1, 4.2, 4.5 i 4.6 svedene na zahtjeve,
    bez obrazloženja. Pull-out na min. 2 ankera po lokaciji umjesto 10 % ugrađenih.
    Novi dokaz 15 — derating agregata, uz ponudu.
    Prilog II: stavka 1.1 skraćena sa 3955 na 1651 znak, 1.2 sa 1103 na 741; iz 1.2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
    [3.1 PRILOG II TD - Obrazac za cijenu ponude LOT 1 - Sjednica i Hamzici.xlsx, 3.1 PRILOG II TD - Obrazac za cijenu ponude LOT 2 - Sjednica i Hamzici.xlsx, E-01.dwg, E-01.dxf, H-01.dwg, H-01.dxf, H-02.dwg, H-02.dxf]
2026-09-15 Obris agregata i spremnika umjesto kocke; kotni lanac na opremi
    Novi zajednički modul cad/genset.py crta agregat i spremnik na M-01 i H-04,
    kao što single_line.py crta E-01 i H-05. Agregat je do sada bio prazan
    pravougaonik bez ijedne kote na sebi; sada nosi ram skida, radijator sa
    ventilatorom, motor, generator, komandni ormar i priključke, te kotni lanac
    1550 × 620 u osnovi i 1020 u presjeku.
    Obris NIJE preuzet iz EQUIPEMENT/GENSET/*.dwg. Ti crteži su automatski
    trasirani iz rastera: vanjski obris tlocrta ima 928 tjemena za pravougaonik,
    a odnos stranica mu je 1072 : 510 = 2,10 umjesto stvarnih 1550 : 620 = 2,50,
    dakle raster nije imao kvadratni piksel. Takav trag se ne smije kotirat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
    [3.1 PRILOG II TD - Obrazac za cijenu ponude LOT 1 - Sjednica i Hamzici.xlsx, 3.1 PRILOG II TD - Obrazac za cijenu ponude LOT 2 - Sjednica i Hamzici.xlsx, E-01.dwg, E-01.dxf, H-01.dwg, H-01.dxf, H-02.dwg, H-02.dxf]
2026-09-16 Pogled sa jugozapada (S-04, H-06); opisne napomene uklonjene sa crteža
    Nova dva lista u Prilogu III, 30 -> 32 strane. Zajednički modul cad/sw_view.py
    crta oba, kao što single_line.py crta jednopolne a genset.py agregat.
    Kosa projekcija nije bila potrebna. Oba kompleksa su zakrenuta 45° i crtaju se
    pravougaono na sebe, pa je jugozapad kod oba jedna od osa plana — na Sjednici
    plan-JUG, na Hamzićima plan-ZAPAD. Pogled je zato prava ortogonalna elevacija:
    bez perspektive, sa mjerljivim visinama i širinama. Skrivene linije se ne
    uklanjaju nego se crta od najdaljeg ka najbližem; noge stuba su šire od
    kontejnera na obje lokacije, pa se ništa ne preklapa.
    Stub je prava geometrija sa slo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
    [3.1 PRILOG II TD - Obrazac za cijenu ponude LOT 1 - Sjednica i Hamzici.xlsx, 3.1 PRILOG II TD - Obrazac za cijenu ponude LOT 2 - Sjednica i Hamzici.xlsx, E-01.dwg, E-01.dxf, H-01.dwg, H-01.dxf, H-02.dwg, H-02.dxf]
2026-09-16 Sklopke i RCD na agregatu sa 63 A na 50 A
    Odluka Naručioca 16.09.2026. Nazivna struja agregata je 26,0 A (18 kVA na
    400 V), deratirana prime 20,8 A, pa 50 A ostavlja faktor 1,9 prema nazivnoj;
    63 A je bilo predimenzionirano. Mijenjaju se tri uređaja, sva tri birana po
    termičkoj struji:
    Q0 4p tropoložajna sklopka izvora 1-0-2 63 -> 50 A
    3p dvopoložajna sklopka 0-1 63 -> 50 A
    FI0 4p RCD 300 mA, S-tip 63 -> 50 A
    Prekostrujna zaštita se NE mijenja i ostaje C 32 A. Agregat je otočni izvor
    ograničene struje kvara: zahtjev PMG/AREP daje ≈78 A tokom ≥10 s, što je
    2,4 × 32 A ali samo 1,56 × 50 A, pa bi podizanje na 50 A oslabilo zaštitu.
    To je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
    [3.1 PRILOG II TD - Obrazac za cijenu ponude LOT 1 - Sjednica i Hamzici.xlsx, 3.1 PRILOG II TD - Obrazac za cijenu ponude LOT 2 - Sjednica i Hamzici.xlsx, E-01.dwg, E-01.dxf, H-01.dwg, H-01.dxf, H-02.dwg, H-02.dxf]
2026-09-16 Oprema u GRO: zatvoren RED-09, Q1 i QS uvedeni na šeme
    Pregled stavke 5.6 prema jednopolnoj šemi i prema 03-electrical.md pokazao je
    da su iz tabele ispravki uz RED-09 ranije usvojene dvije stavke (RCD 300 mA
    S-tip i RCBO 30 mA tip A), a dvije nisu. Uz to su dva uređaja iz predmjera
    nedostajala na E-01 i H-05, pa se predmjer i šema nisu slagali o sadržaju
    ormara.
    Predmjer, stavka 5.6 (BOTH_SITES_EDITS, obje lokacije):
    - 3 × 1p C 32 A na trofaznom dovodu -> 1 × 4p (3P+N) kompaktni prekidač Q1
    32 A sa podesivim magnetnim okidanjem. Jednopolno okidanje ostavlja agregat
    u jednofaznom radu sa dvije faze pod naponom i ne prekida N; uz to C-kriva
    na raspoloživih ≈78 A nikad ne oki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
    [3.1 PRILOG II TD - Obrazac za cijenu ponude LOT 1 - Sjednica i Hamzici.xlsx, 3.1 PRILOG II TD - Obrazac za cijenu ponude LOT 2 - Sjednica i Hamzici.xlsx, E-01.dwg, E-01.dxf, H-01.dwg, H-01.dxf, H-02.dwg, H-02.dxf]
2026-09-16 Traka isporuke umjesto šrafure preko lica kutije na jednopolnim šemama
    Preko cijele kutije ANSI31 i ANSI37 su na 1:50 davali dvije-tri velike
    dijagonale koje su prolazile kroz natpise: nije se čitala ni šrafura ni tekst,
    a u legendi su uzorci bili gotovo prazni.
    Šrafura je sada traka visine 180 jedinica (3,6 mm na listu) uz donju ivicu
    kutije, sa linijom razgraničenja. Uzorak je u traci gušći pa se prepoznaje
    (ANSI31 na SC × 0,5, ANSI37 na SC × 0,6 umjesto SC × 4 i SC × 8), a lice
    kutije ostaje čisto. Uzorci u legendi su umanjene kutije sa istom trakom,
    umjesto ranijih praznih pravougaonika.
    Dogovor se ne mijenja: ANSI31 = isporuka i montaža Izvođača, ANSI37 = oprema
    Kupca.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
    [3.1 PRILOG II TD - Obrazac za cijenu ponude LOT 1 - Sjednica i Hamzici.xlsx, 3.1 PRILOG II TD - Obrazac za cijenu ponude LOT 2 - Sjednica i Hamzici.xlsx, E-01.dwg, E-01.dxf, H-01.dwg, H-01.dxf, H-02.dwg, H-02.dxf]
2026-10-05 Silueta stuba H-06 centrirana, formalne i manje napomene, trake FN u nivou ploče na Hamzićima
    - extract_tower.py: osa stuba je sredina cijele siluete; kod Hamzića je stub ispadao
    pomaknut za pola baze udesno (H-06). tower_profile.json Hamzića ponovo izvučen.
    - Napomene na svim listovima: tekst 1,7 mm (naslov 2,2 mm), jednopolne šeme 1,5 mm;
    formulacije u punim rečenicama, bez skraćenica i verzala.
    - Hamzići: vrh temeljnih traka u nivou ploče, 0,20 m iznad terena (Naručilac
    05.10.2026). Kote polja od ploče (+0,50 / +2,93), nadvišenje ograde 1,13 m.
    Traka ista (900 mm, 9,36 m³), rov 750 mm: iskop i odvoz 7,80 m³, obrada 20,3 m².
    H-03 i H-06 pregenerisani; Prilog I, Pr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
    [3.1 PRILOG II TD - Obrazac za cijenu ponude LOT 1 - Sjednica i Hamzici.xlsx, 3.1 PRILOG II TD - Obrazac za cijenu ponude LOT 2 - Sjednica i Hamzici.xlsx, E-01.dwg, E-01.dxf, H-01.dwg, H-01.dxf, H-02.dwg, H-02.dxf]
2026-10-05 Kratke formalne napomene; Prilog II ostaje kako je izdat
    - Napomene na svim listovima skraćene: jedna rečenica po tački, formalno.
    - Prilog II se ne mijenja (Naručilac 05.10.2026): joint_boq.py, check_boq_recalc.py i
    oba obrasca vraćeni na main; količine iskopa, odvoza i obrade ostaju 9,88 / 9,88 /
    10,4. Prilog I, proračuni i design.json ne navode nove količine; ostaje samo kota
    traka u nivou ploče i nadvišenje ograde 1,13 m.
    - rules_joint: 0,93 m u stavci 1.1 izdatog Priloga II nije greška.
    [3.1 PRILOG II TD - Obrazac za cijenu ponude LOT 1 - Sjednica i Hamzici.xlsx, 3.1 PRILOG II TD - Obrazac za cijenu ponude LOT 2 - Sjednica i Hamzici.xlsx, E-01.dwg, E-01.dxf, H-01.dwg, H-01.dxf, H-02.dwg, H-02.dxf]
